Rhiiino/van-gogh/models/README.md

# Van Gogh — Models

STL files for the printed parts of one barrel. One file is one part.
