Rhiiino/van-gogh/media/README.md

# Van Gogh — Media

Photos and renders for the landing page. The printed-parts catalog is [catalog.md](../catalog.md).

## Images

| File | Use |
| --- | --- |
| `cover.png` | First image in [README.md](../README.md) |
| `hero-assembled.jpg` | Assembled barrel |
| `assembled-side.jpg` | Electronics side |
| `assembled-end.jpg` | Indexer end |
| `assembled-front.jpg` | Muzzle three-quarter |
| `assembled-top.jpg` | Top three-quarter |

## GIFs

| File | Use |
| --- | --- |
| `explode-assembled-to-open.gif` | Barrel explode, assembled to exploded and back |
| `explode-loop-centered-label.gif` | Centered explode with label |
| `explode-loop-centered-label-round.gif` | Same loop, Rival round left of the label |
| `explode-loop-end.gif` | Same loop from the indexer end |
| `explode-dial-label.gif` | DIAL explode with label |
| `explode-dial-framed-label.gif` | DIAL explode, open pose framed |
| `dial-cycle.gif` | DIAL cycle — feed, cam plunger, flywheel shots |
| `lasenoid-cycle-viewport-laser.gif` | Solid viewport, Material Preview laser |
