Rhiiino/van-gogh/catalog.md

# Van Gogh — Parts catalog

Visual index of printed parts for one barrel. One section per part. Quantities and specs: [bom.md](bom.md).

---

## actuation rod

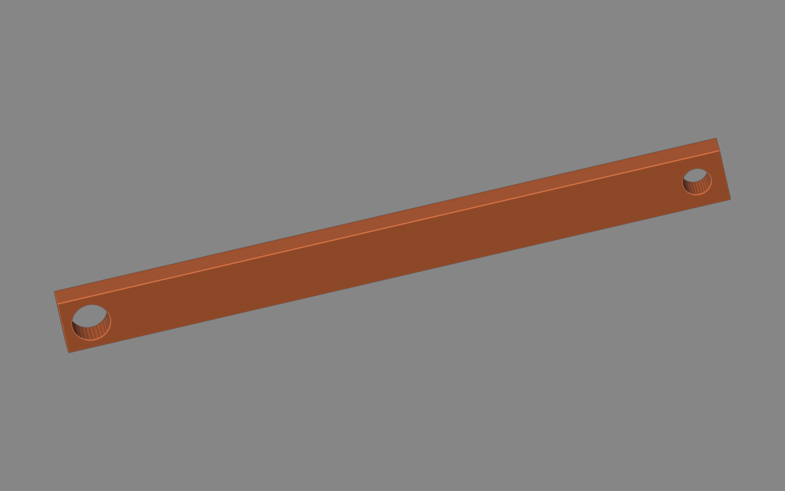
[picture p8: catalog/actuation-rod.png]
actuation rod


## ammo guide

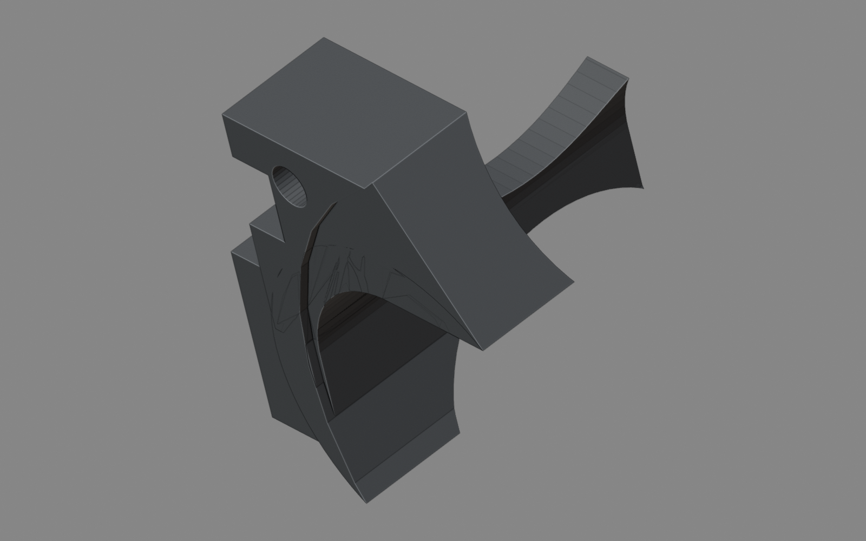
[picture p9: catalog/ammo-guide.png]
ammo guide


## barrel base L panel

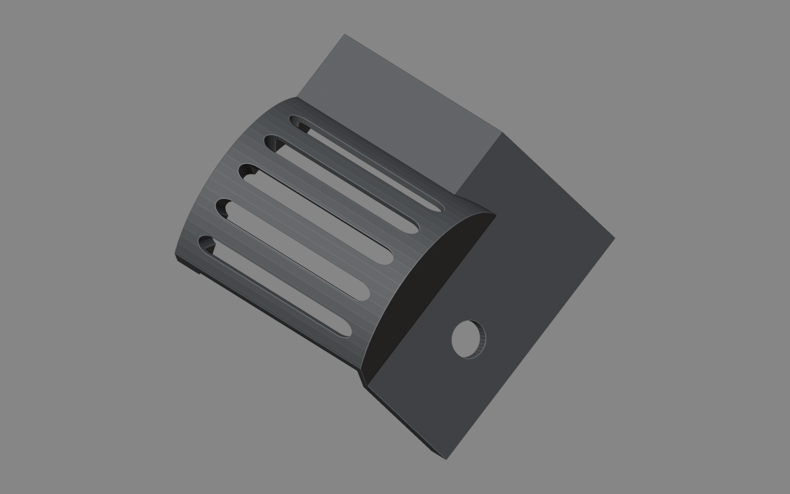
[picture p10: catalog/barrel-base-l-panel.png]
barrel base L panel


## barrel base R panel

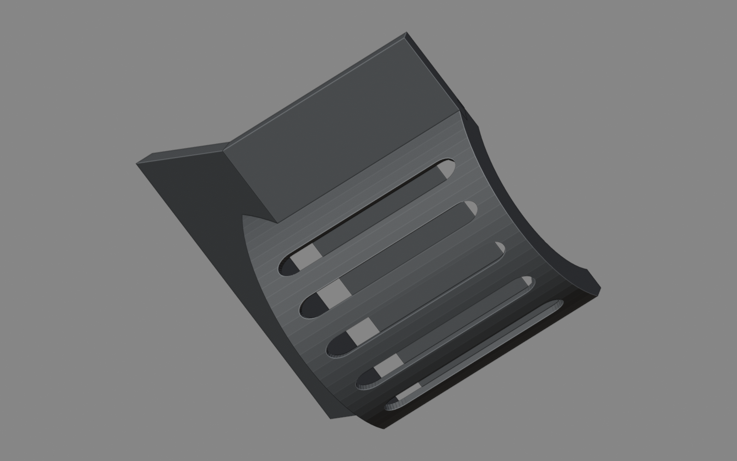
[picture p11: catalog/barrel-base-r-panel.png]
barrel base R panel


## barrel middle

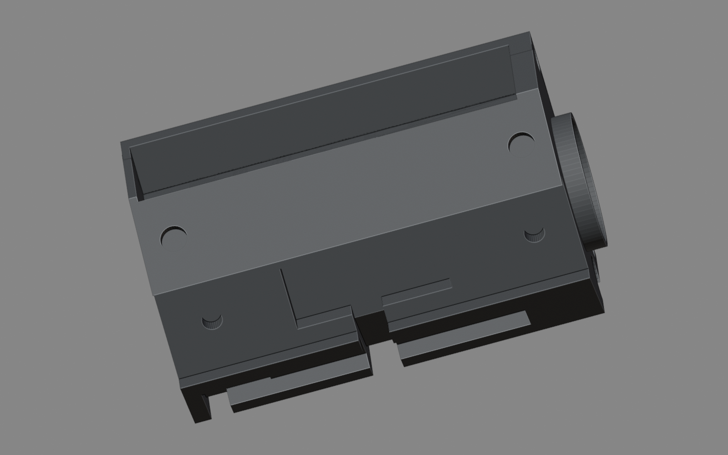
[picture p12: catalog/barrel-middle.png]
barrel middle


## BCU cover

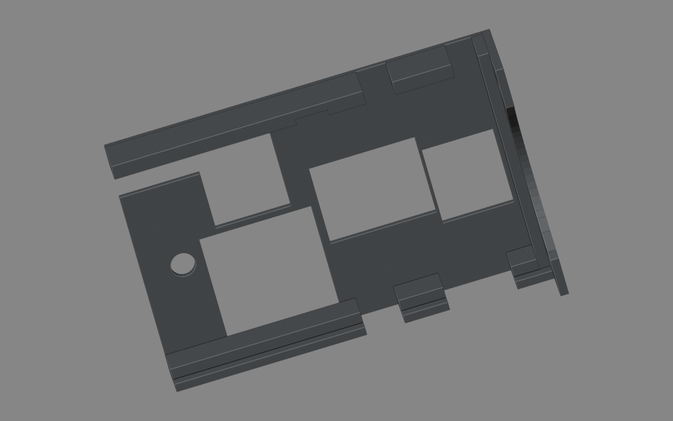
[picture p13: catalog/bcu-cover.png]
BCU cover


## cone

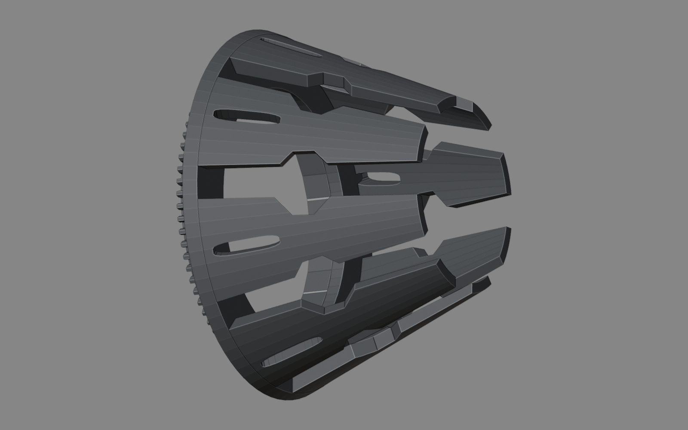
[picture p14: catalog/cone.png]
cone


## drum cam

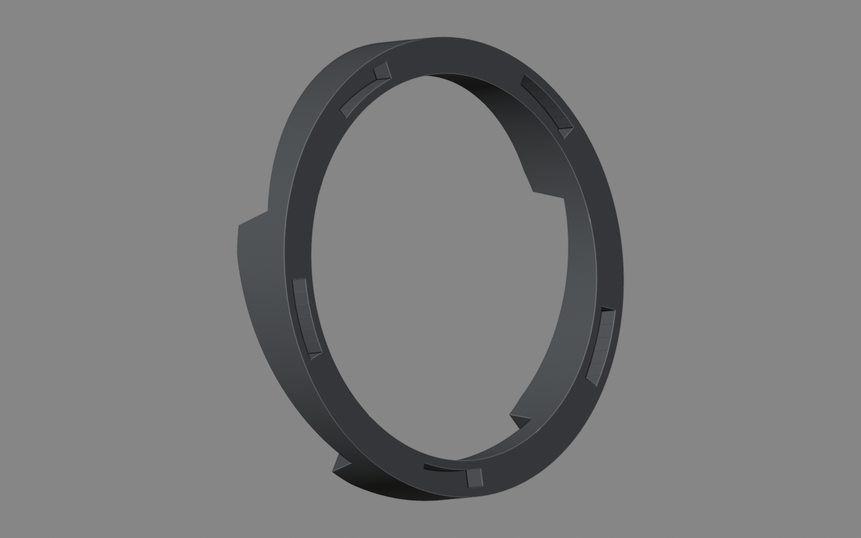
[picture p15: catalog/drum-cam.png]
drum cam


## drum main

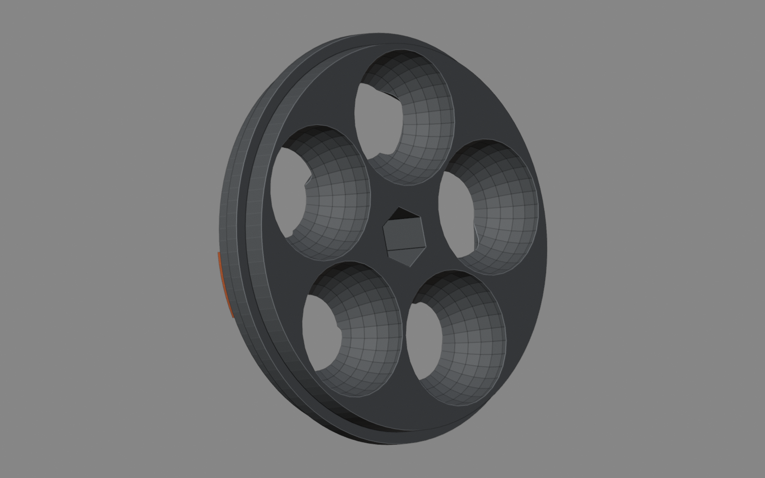
[picture p16: catalog/drum-main.png]
drum main


## drum motor shaft

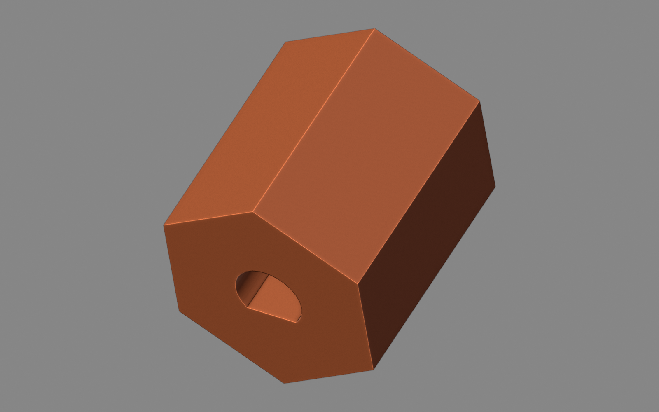
[picture p17: catalog/drum-motor-shaft.png]
drum motor shaft


## ESC casing

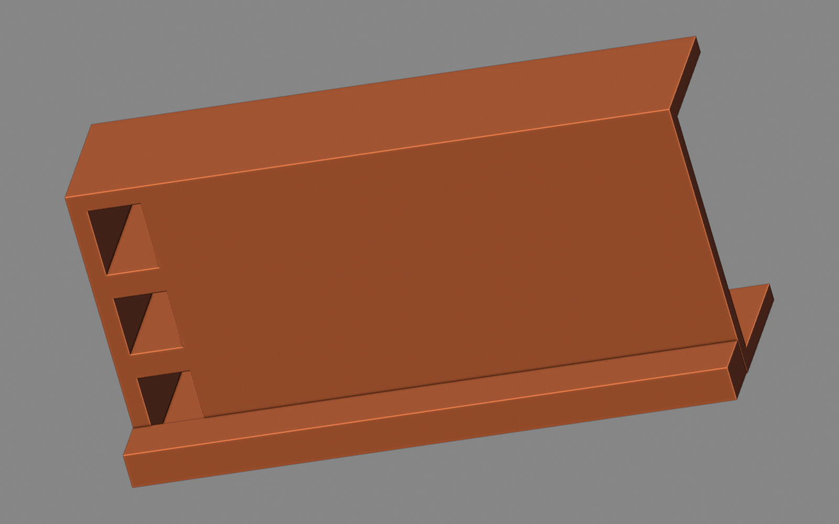
[picture p18: catalog/esc-casing.png]
ESC casing


## flywheel

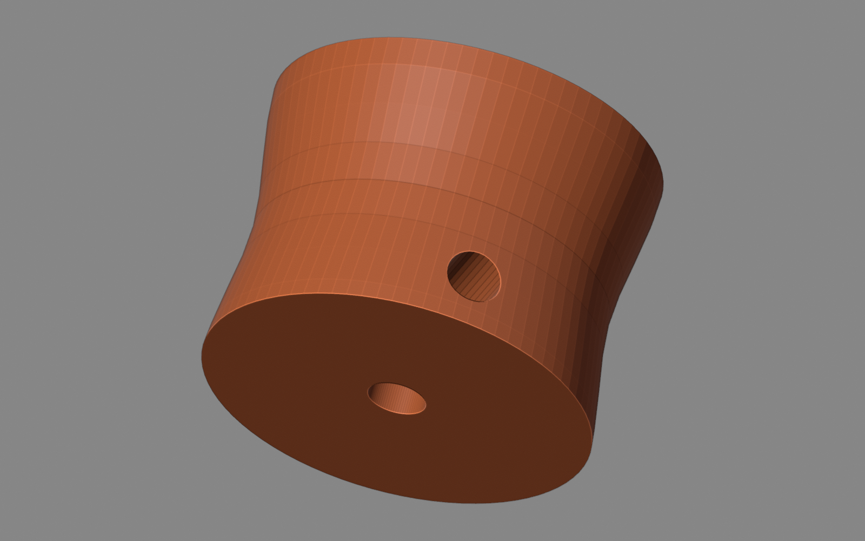
[picture p19: catalog/flywheel.png]
flywheel


## flywheel base

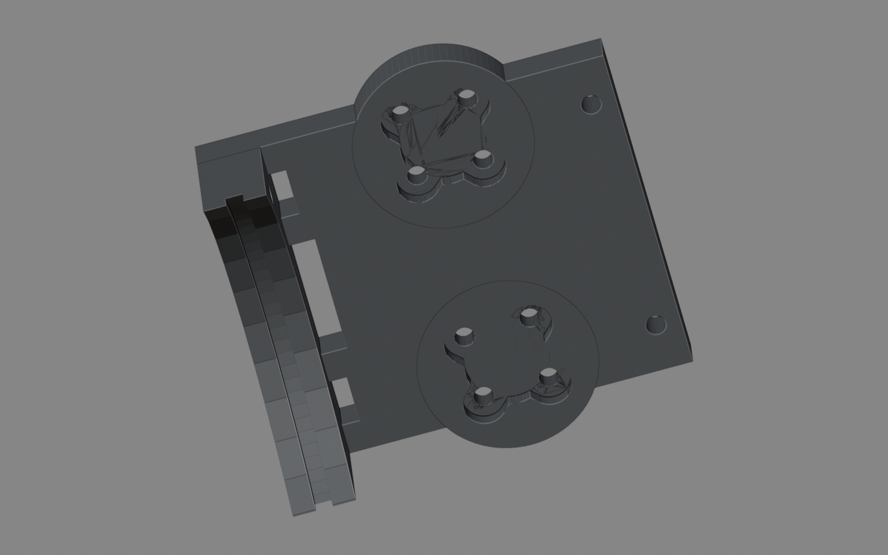
[picture p20: catalog/flywheel-base.png]
flywheel base


## flywheel carriage

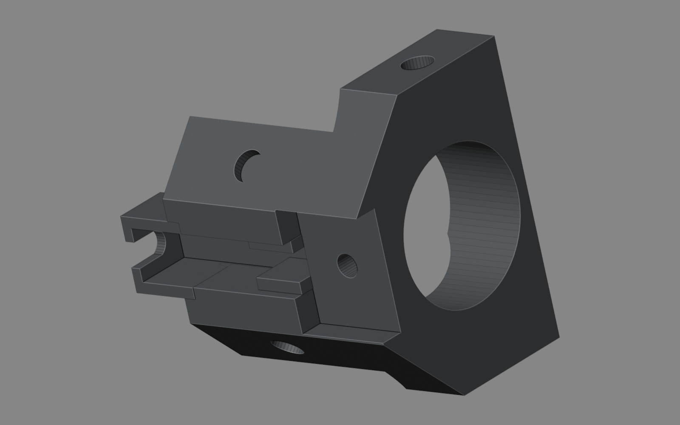
[picture p21: catalog/flywheel-carriage.png]
flywheel carriage


## lasenoid base

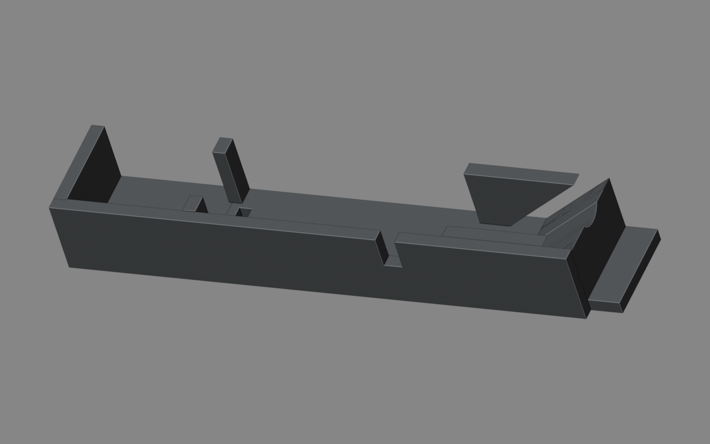
[picture p22: catalog/lasenoid-base.png]
lasenoid base


## laser carriage

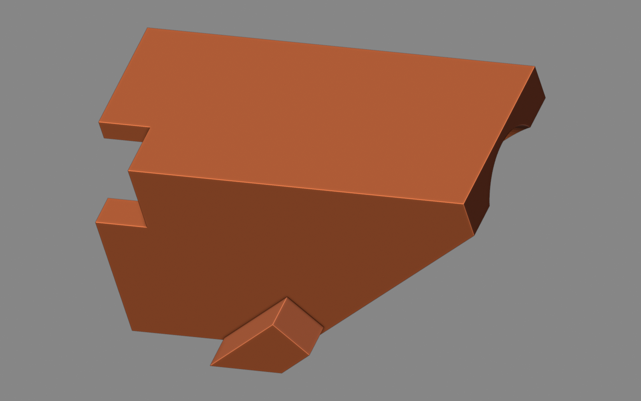
[picture p23: catalog/laser-carriage.png]
laser carriage


## led & cone n20 motor panel

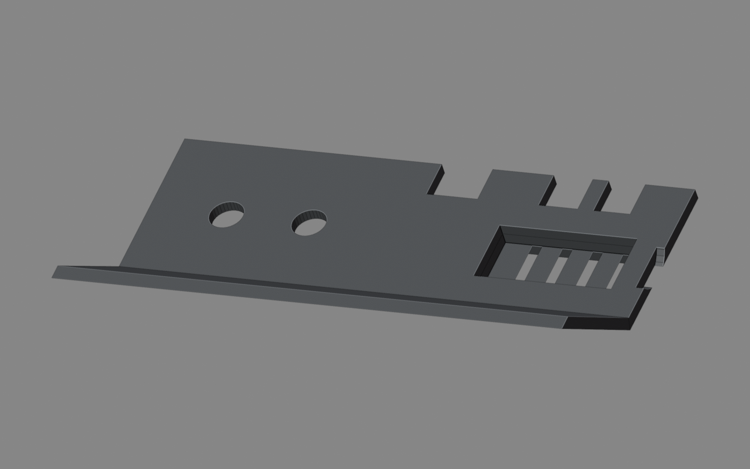
[picture p24: catalog/led-cone-n20-motor-panel.png]
led & cone n20 motor panel


## magazine lid

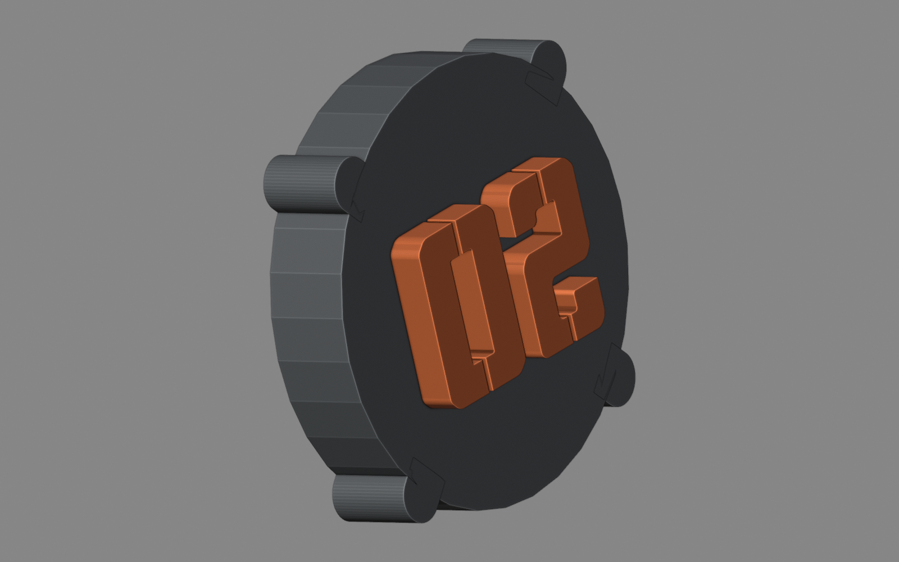
[picture p25: catalog/magazine-lid.png]
magazine lid


## magazine main

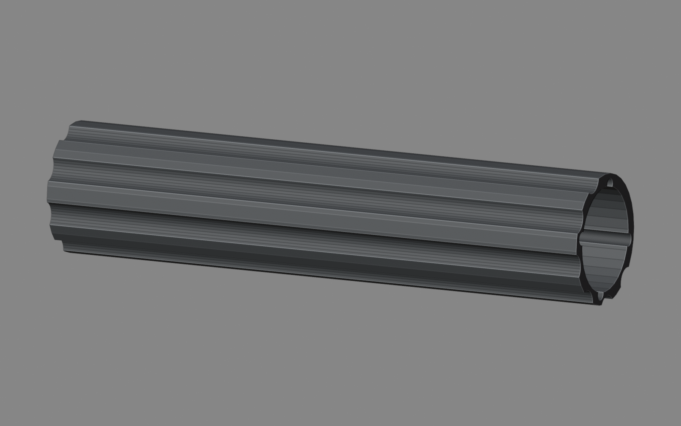
[picture p26: catalog/magazine-main.png]
magazine main


## magazine mount

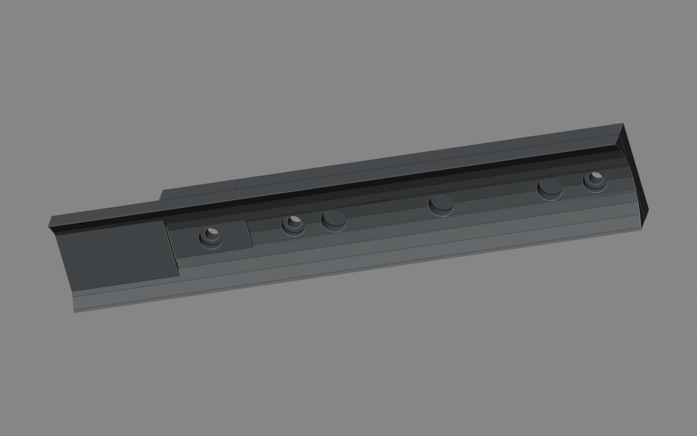
[picture p27: catalog/magazine-mount.png]
magazine mount


## magazine pusher

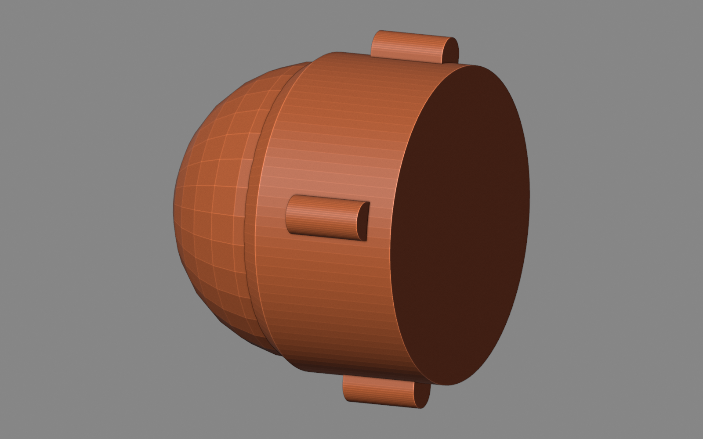
[picture p28: catalog/magazine-pusher.png]
magazine pusher


## module - name plate

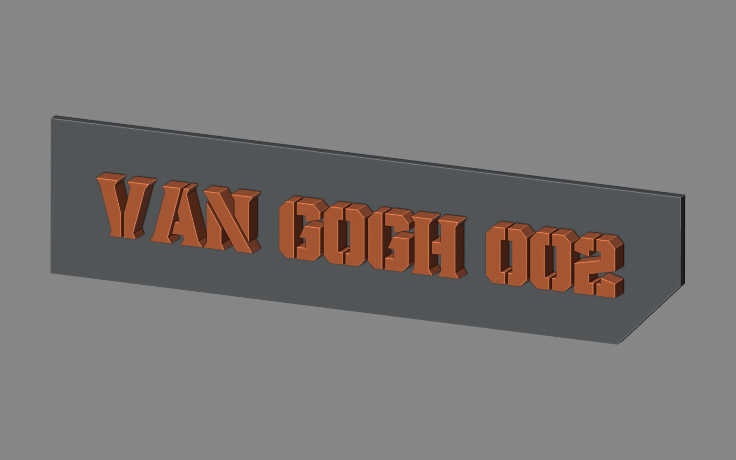
[picture p29: catalog/module-name-plate.png]
module - name plate


## name & lasenoid panel

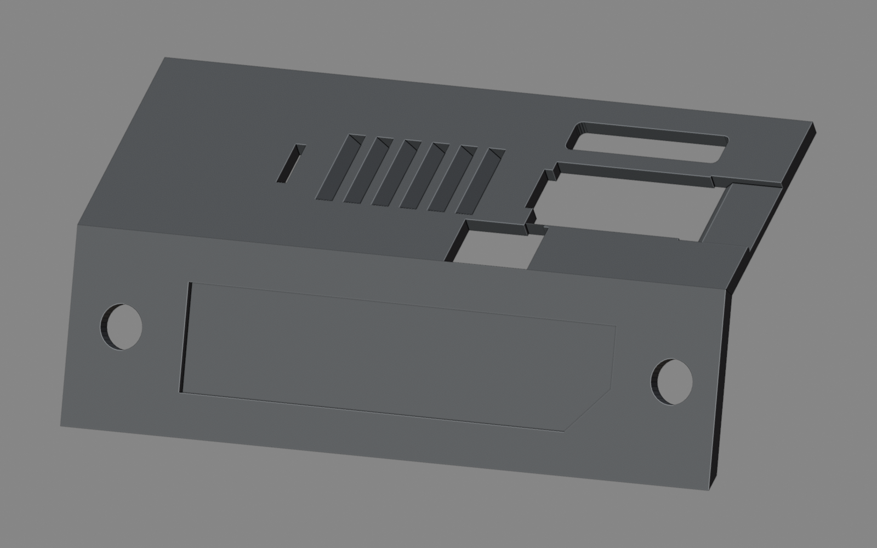
[picture p30: catalog/name-lasenoid-panel.png]
name & lasenoid panel


## PH ceiling / PYE connector

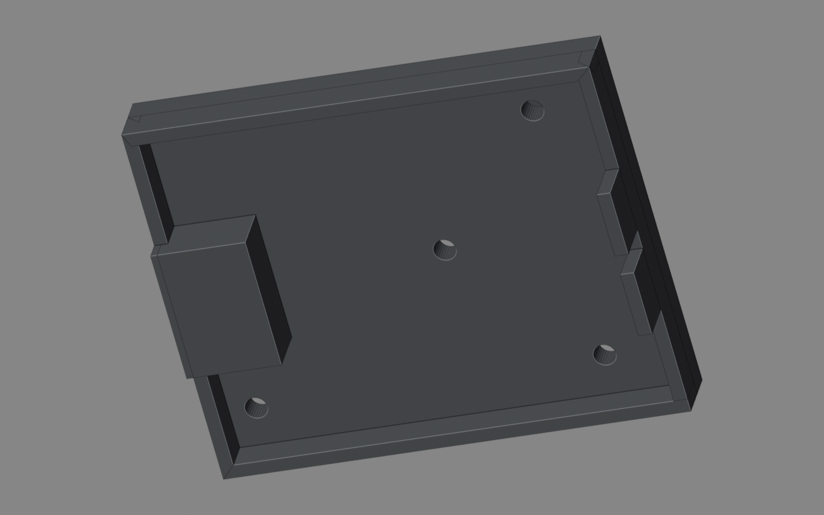
[picture p31: catalog/ph-ceiling-pye-connector.png]
PH ceiling / PYE connector


## pinion gear

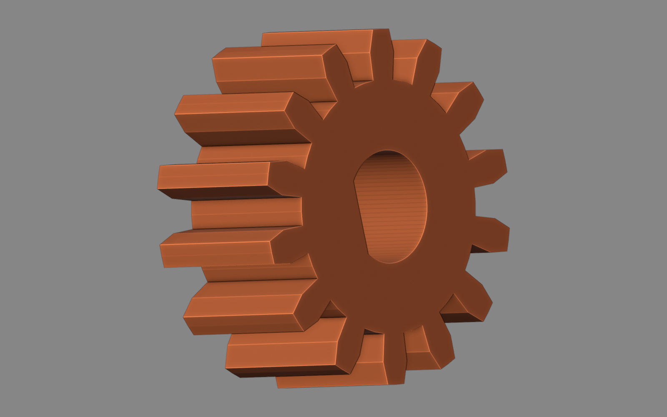
[picture p32: catalog/pinion-gear.png]
pinion gear


## plunger

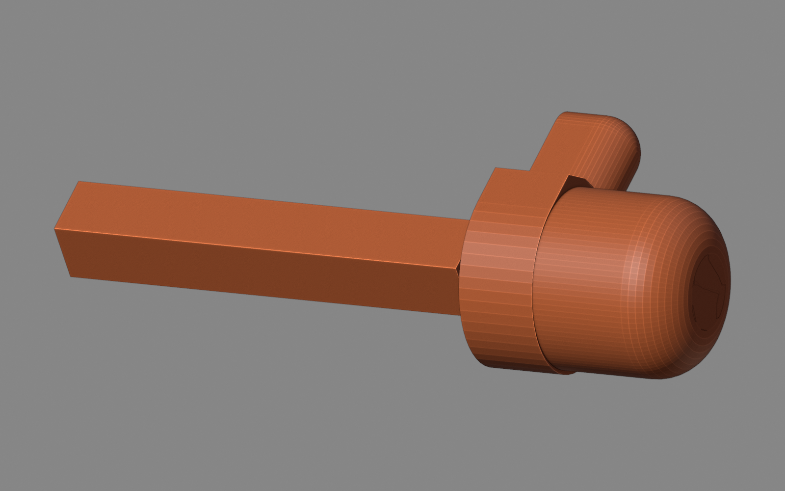
[picture p33: catalog/plunger.png]
plunger


## plunger mount

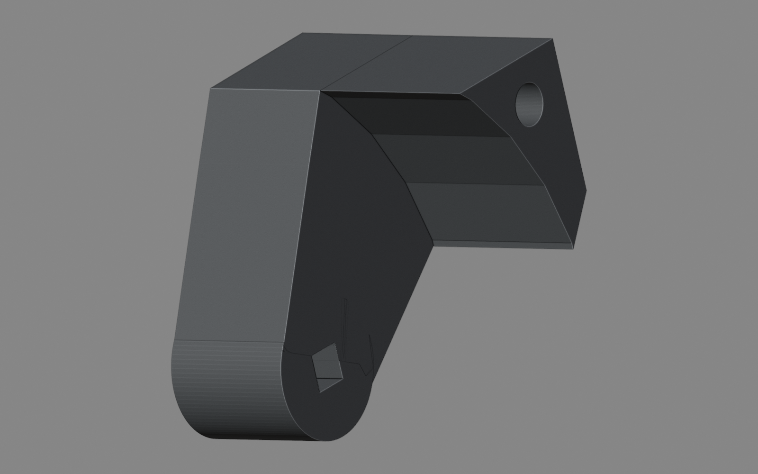
[picture p34: catalog/plunger-mount.png]
plunger mount


## power housing

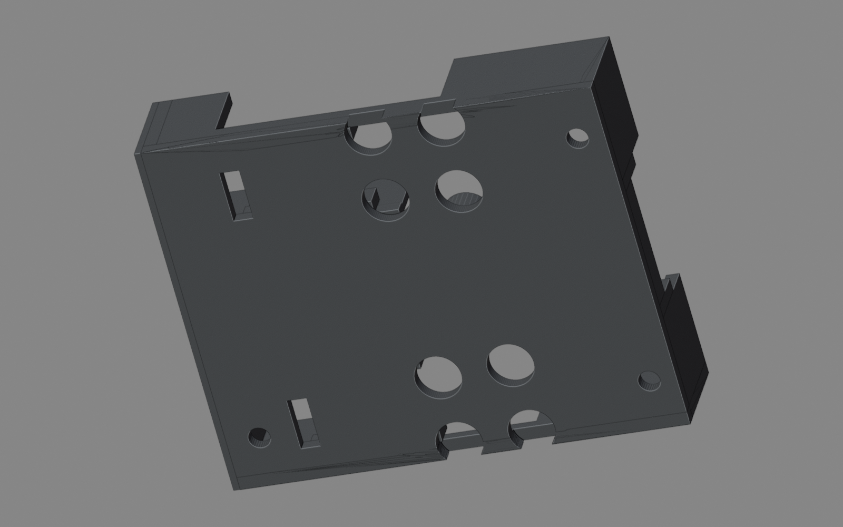
[picture p35: catalog/power-housing.png]
power housing


## solenoid / rod pin

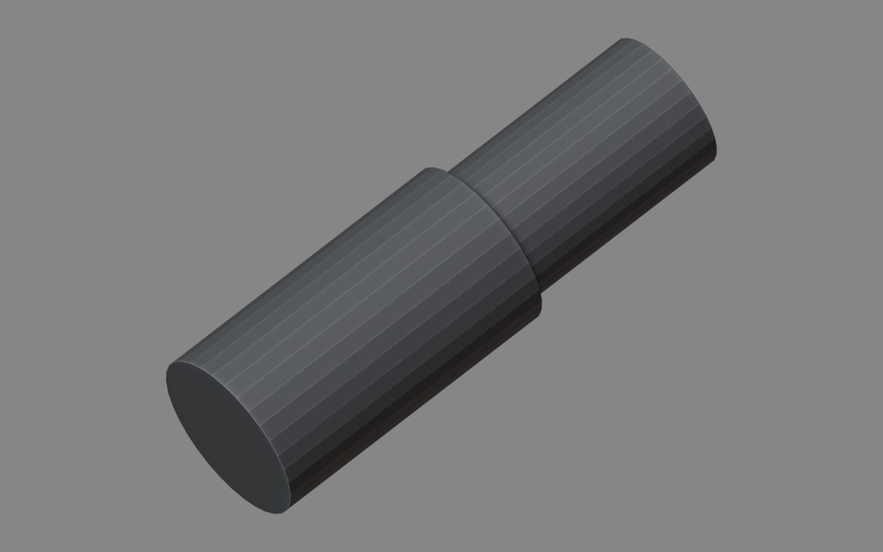
[picture p36: catalog/solenoid-rod-pin.png]
solenoid / rod pin
