Rhiiino/van-gogh/media/gifs/explode-dial-framed-label.gif

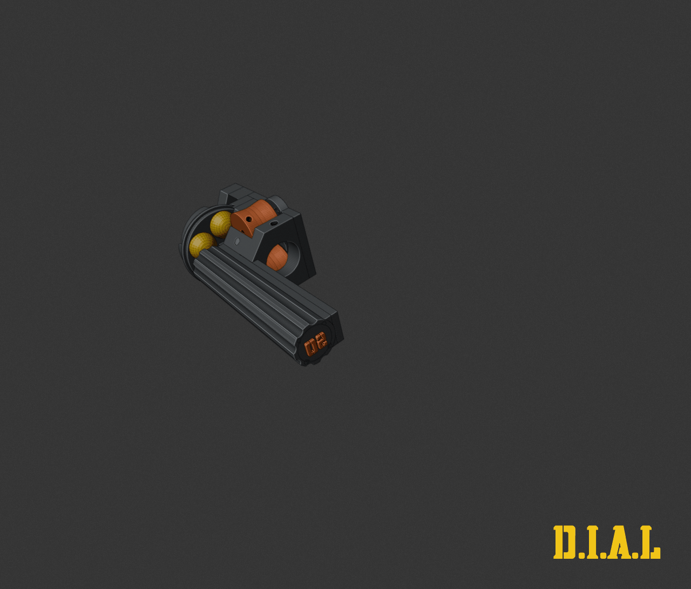
media/gifs/explode-dial-framed-label.gif
