Rhiiino/van-gogh/media/gifs/explode-dial-label.gif

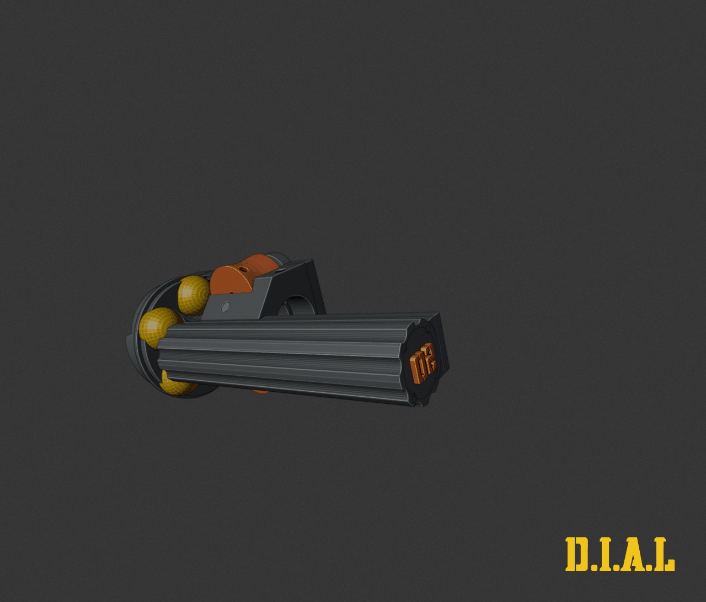
media/gifs/explode-dial-label.gif
