Rhiiino/van-gogh/media/gifs/explode-loop-end.gif

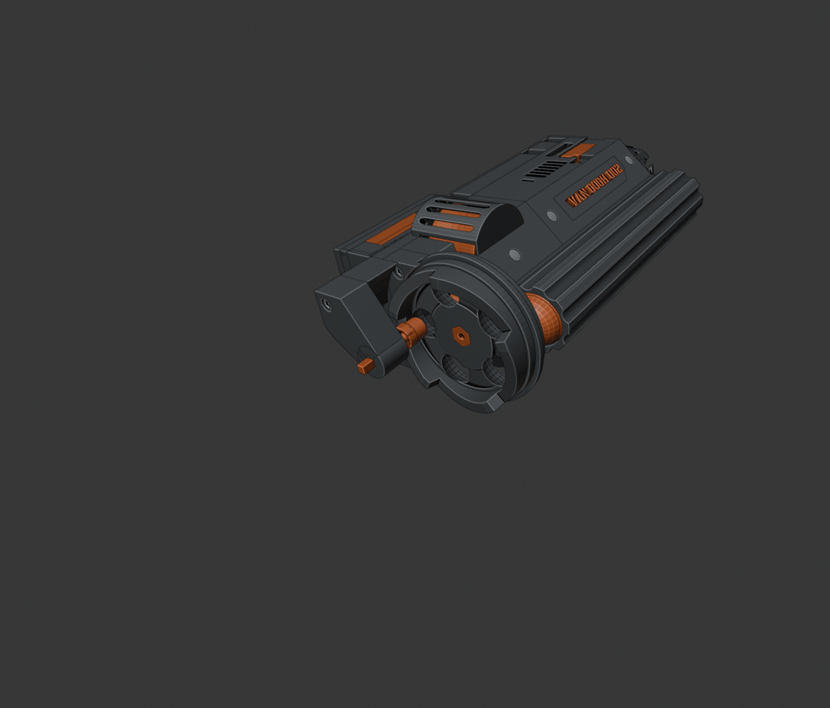
media/gifs/explode-loop-end.gif
