Rhiiino/van-gogh/cost.md

# Van Gogh — cost

Bought parts for **one** barrel. Printed parts are excluded. Quantities: [bom.md](bom.md).

**Total: $140.84**

Each line is this barrel’s share of the listing: pack price × quantity on the barrel ÷ pieces in the pack. Rows marked **est.** use a pack listing from 2026-10-10. Tax and shipping are omitted. The logic-board line is the amount paid for order Y14-2705430A, split across the five boards.

| Group | This barrel |
| --- | ---: |
| Mechanical | $79.02 |
| Fasteners | $3.50 |
| Connectors | $3.87 |
| Logic board | $54.45 |
| **Total** | **$140.84** |

Flywheel motors, the two ESCs, and the Pololu 6 V buck are $95.95 of the total.

## Mechanical

| Part | Qty | Listing | This barrel |
| --- | ---: | ---: | ---: |
| iFlight XING-E Pro 2207 1800KV | 2 | $70.99 / 4 | $35.50 |
| HNYYZL/LANRC 45A BLHeli_S ESC | 2 | $40.99 / 4 | $20.50 |
| uxcell 6706-2RS ring bearing | 1 | $7.31 | $7.31 |
| WS2812B LED stick | 1 | $5.95 est. | $5.95 |
| DWEII N20 | 2 | $9.99 / 4 est. | $5.00 |
| MEETOOT SM0537 solenoid, 6 V / 1.5 A | 1 | $7.99 / 2 est. | $4.00 |
| HiLetgo 5 V 650 nm laser | 1 | $6.79 / 10 est. | $0.68 |
| Plunger spring, 0.5 × 6 × 30 mm | 1 | $11.99 / 150 | $0.08 |

The motor 4-pack and the ESC 4-pack each cover two barrels. This table takes half of each.

## Fasteners

22 magnets, 12 M3 heat-set inserts, 20 M3 bolts. Eight of the bolts thread into the flywheel motors and have no insert.

| Part | Qty | Listing | This barrel |
| --- | ---: | ---: | ---: |
| 6 × 2 mm neodymium magnet | 22 | $8.99 / 100 est. | $1.98 |
| M3 heat-set insert | 12 | $9.99 / 130 est. | $0.92 |
| M3 bolt (6 / 8 / 12 / 35 mm) | 20 | ~$6 assortment est. | $0.60 |

## Connectors

| Part | Qty | Listing | This barrel |
| --- | ---: | ---: | ---: |
| Micro-Fit 3.0 1×6 pair | 1 | $21.99 / 60 housings | $0.73 |
| JST-PH 2.0 pigtails, 24 AWG | 5 | $16.99 / 120 wires | $1.56 |
| JST-PH 2.0 right-angle headers | 5 | $10.99 / 95 | $0.58 |
| XT90 male | 1 | $9.99 / 5 pair est. | $1.00 |

The Micro-Fit kit is 60 housings (30 male, 30 female), including two 1×6 of each gender. This barrel uses one pair, counted as 2 housings. The PH header kit is 95 right-angle headers; this barrel uses five (four 2-pin, one 3-pin). The pigtail kit includes 120 pre-crimped wires; this barrel uses 11 of them, two per 2-pin lead and three for the LED stick.

## Logic board

Refs: [board.md](board.md).

| Part | Qty | Listing | This barrel |
| --- | ---: | ---: | ---: |
| Pololu D36V50F6, +6 V | 1 | $39.95 | $39.95 |
| Aideepen ESP32-S3 Mini | 1 | $18.99 / 4 est. | $4.75 |
| Logic PCB, JLCPCB Y14-2705430A | 1 | $11.78 / 5 | $2.36 |
| MP1584EN, +5 V | 1 | $9.65 / 6 est. | $1.61 |
| IRLR024N (laser + solenoid) | 2 | $6.99 / 10 est. | $1.40 |
| WWZMDiB DRV8833 | 1 | $7.99 / 6 | $1.33 |
| Machined round male header, 1×40 | 1 | $0.95 | $0.95 |
| 2.54 mm square female header strip | 1 | $8.63 / 10 est. | $0.86 |
| Machined round female header, 1×40 | 1 | $0.55 | $0.55 |
| 100 µF 50 V electrolytic | 1 | $5.99 / 15 | $0.40 |
| 1206 ceramics (4 × 100 nF, 2 × 10 µF) | 6 | $7.99 / 320 | $0.15 |
| 1206 resistors (4 × 100 Ω, 2 × 10 kΩ, 1 × 330 Ω) | 7 | $9.99 / 1200 | $0.06 |
| 100 µF 16 V electrolytic | 2 | $16.99 / 630 | $0.05 |
| SS34 flyback diode | 1 | $8.99 / 300 est. | $0.03 |

The PCB order was five boards: merchandise $4.00, shipping $7.01, tax $0.77, paid $11.78. One board is $2.36. The ESP32 4-pack covers this barrel plus three other boards. One machined-header strip of each gender covers the ESP32-S3 Mini and the MP1584. One square-header strip covers the Pololu socket and the DRV8833 socket.
