Rhiiino/van-gogh/models/magazine main.stl

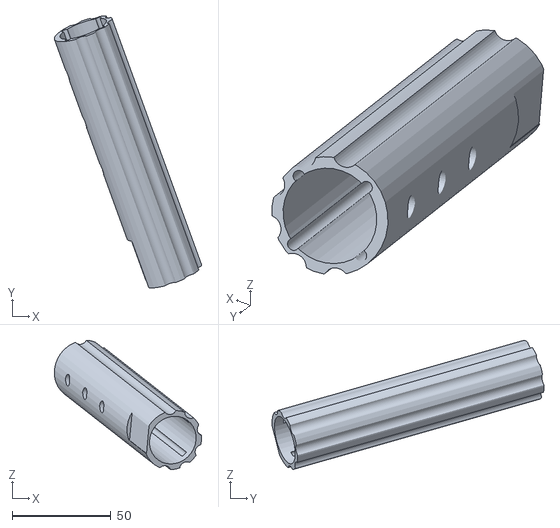
[picture p40: CAD file, 2026-10-12]
models/magazine main.stl
74.5 x 137.6 x 65.4
