Rhiiino/van-gogh/models/drum main.stl

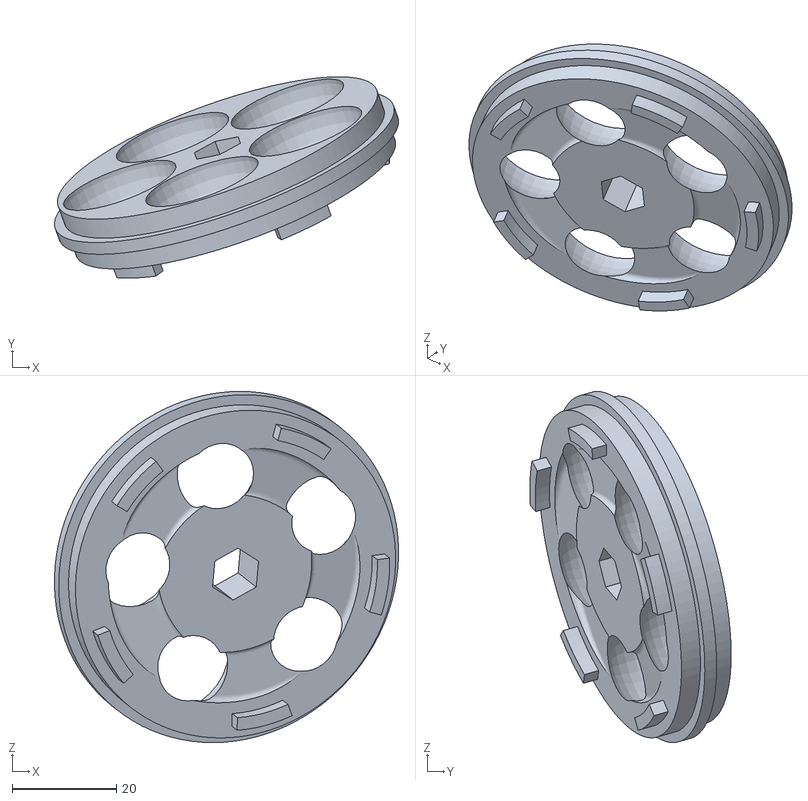
[picture p41: CAD file, 2026-10-12]
models/drum main.stl
65.9 x 38.6 x 67.3
