Rhiiino/van-gogh/models/plunger.stl

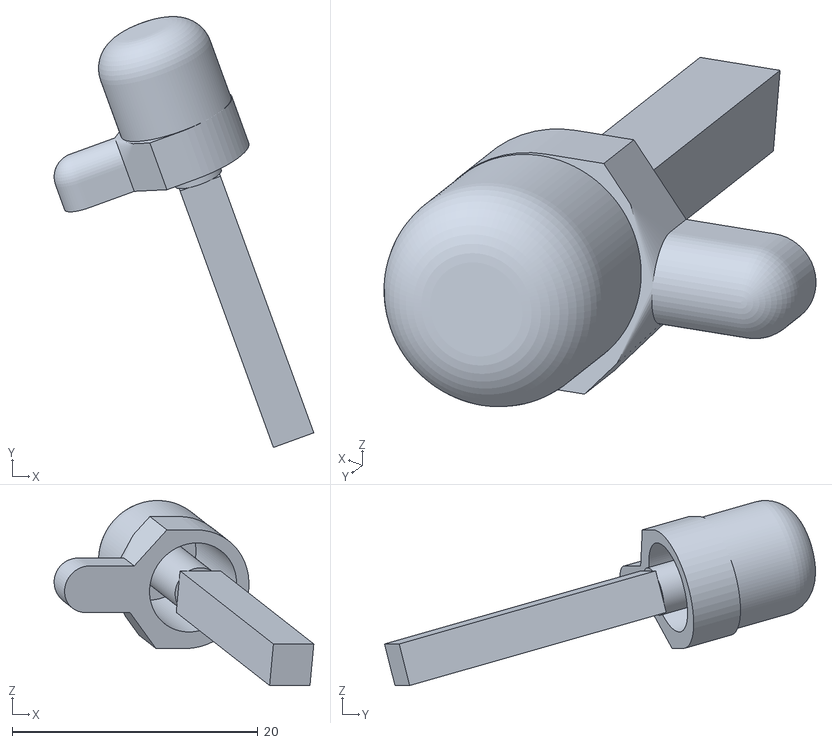
[picture p42: CAD file, 2026-10-12]
models/plunger.stl
21.1 x 35.1 x 15.1
