Rhiiino/van-gogh/models/flywheel.stl

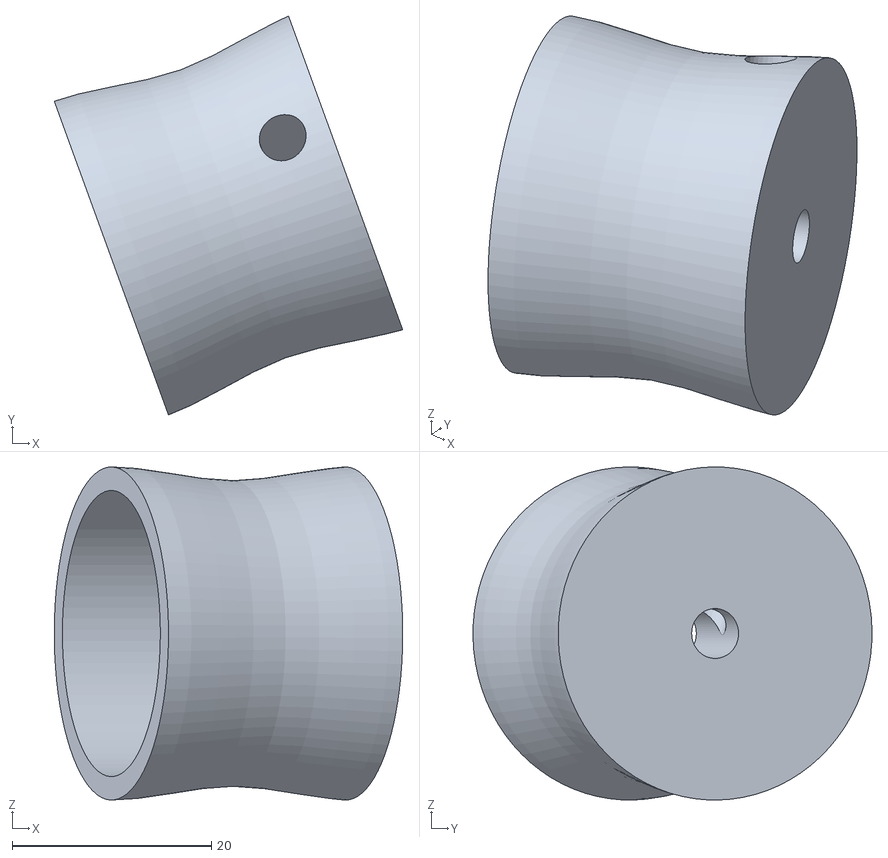
[picture p43: CAD file, 2026-10-12]
models/flywheel.stl
34.9 x 40.0 x 33.4
