Rhiiino/van-gogh/models/BCU cover.stl

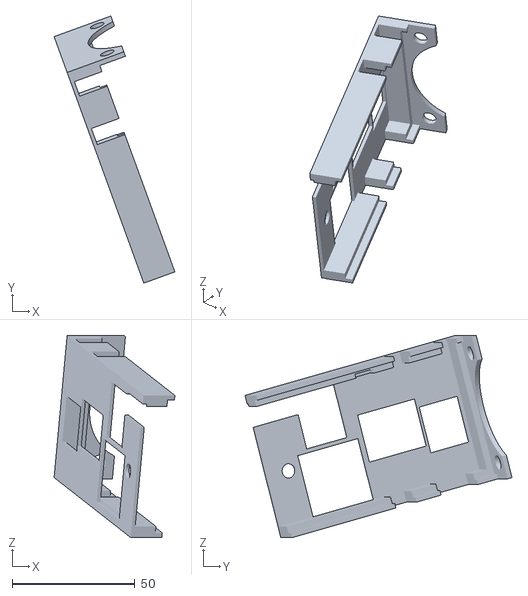
[picture p44: CAD file, 2026-10-12]
models/BCU cover.stl
49.3 x 108.9 x 82.5
