Rhiiino/van-gogh/models/ammo guide.stl

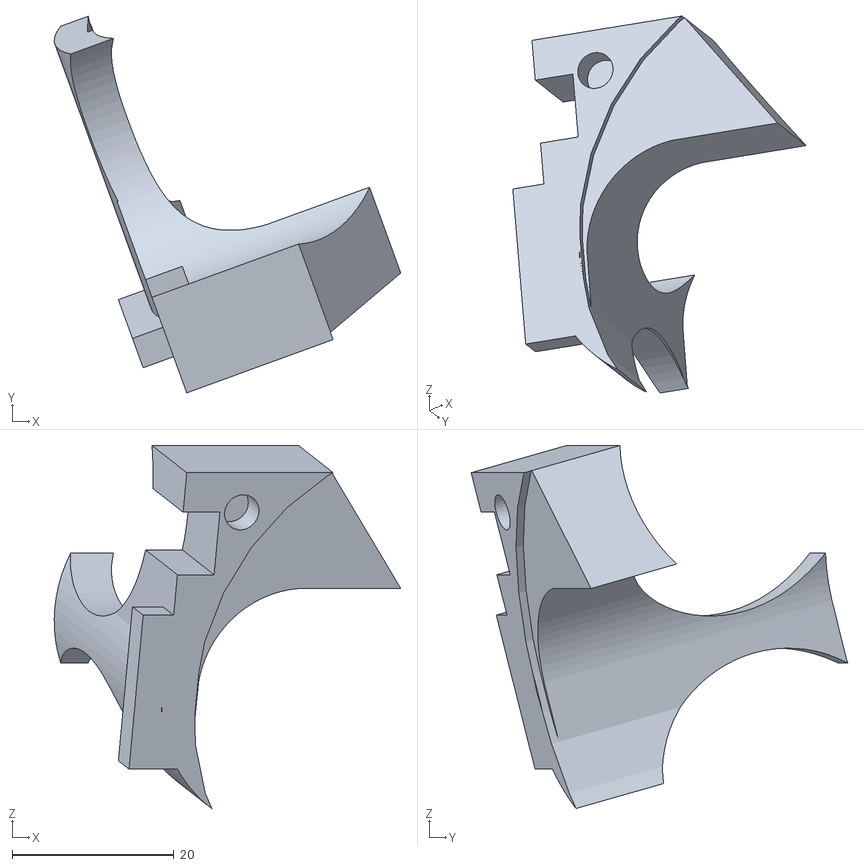
[picture p45: CAD file, 2026-10-12]
models/ammo guide.stl
42.8 x 46.5 x 44.9
