Rhiiino/van-gogh/models/magazine mount.stl

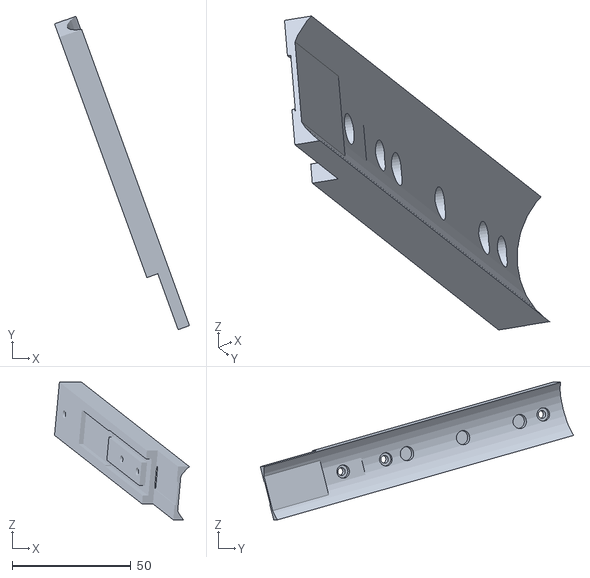
[picture p46: CAD file, 2026-10-12]
models/magazine mount.stl
56.8 x 131.8 x 57.9
