Rhiiino/van-gogh/models/flywheel carriage.stl

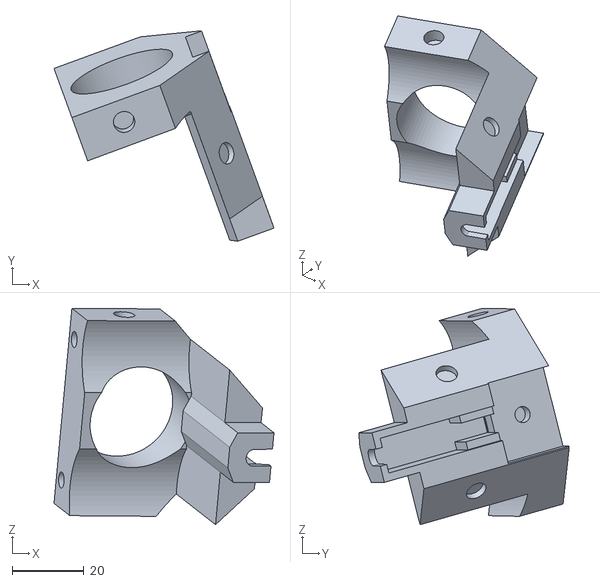
[picture p47: CAD file, 2026-10-12]
models/flywheel carriage.stl
61.2 x 58.6 x 60.2
