Rhiiino/van-gogh/models/pinion gear.stl

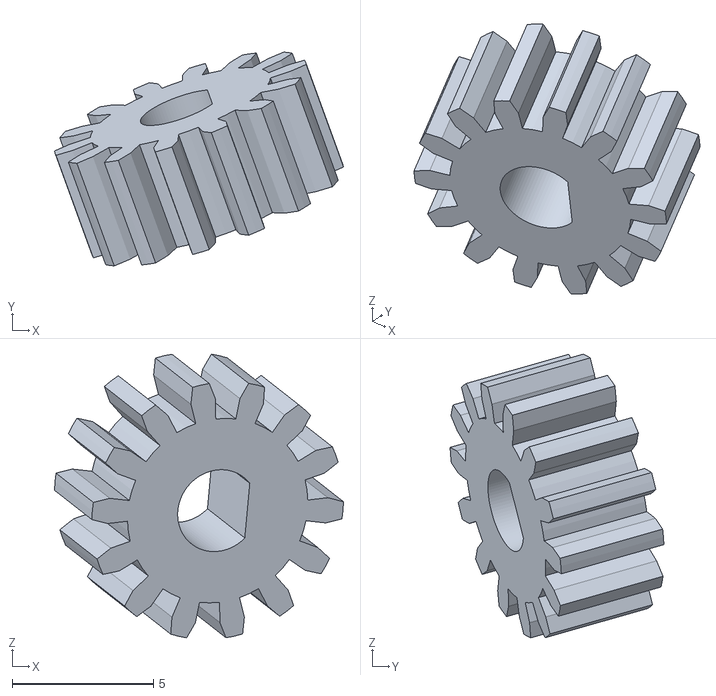
[picture p48: CAD file, 2026-10-12]
models/pinion gear.stl
10.2 x 7.57 x 10.0
