Rhiiino/van-gogh/models/cone.stl

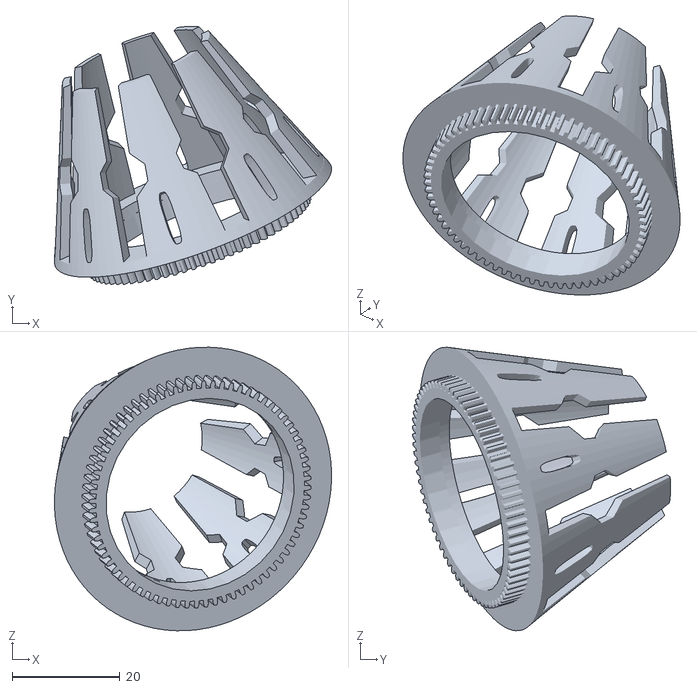
[picture p49: CAD file, 2026-10-12]
models/cone.stl
51.4 x 47.9 x 52.6
