Rhiiino/van-gogh/models/magazine lid.stl

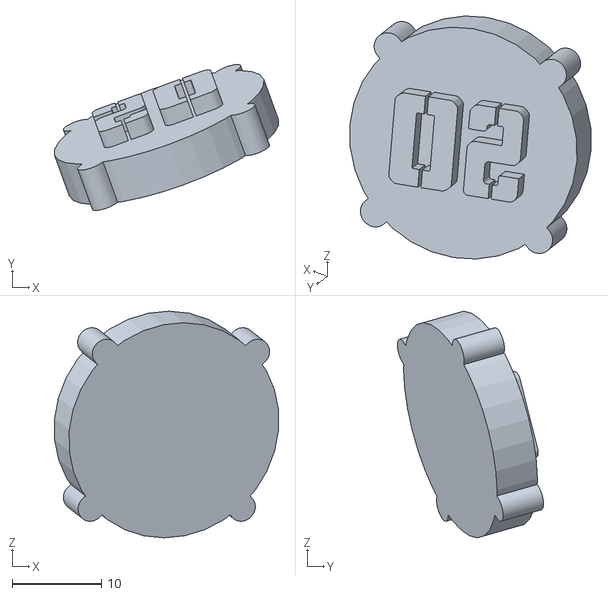
[picture p50: CAD file, 2026-10-12]
models/magazine lid.stl
25.1 x 16.4 x 25.4
