Rhiiino/van-gogh/models/name & lasenoid panel.stl

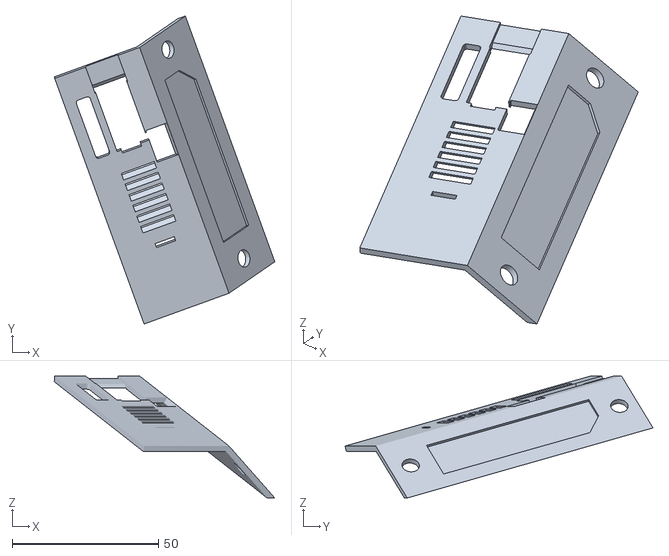
[picture p51: CAD file, 2026-10-12]
models/name & lasenoid panel.stl
75.5 x 105.4 x 41.7
