Rhiiino/van-gogh/models/flywheel base.stl

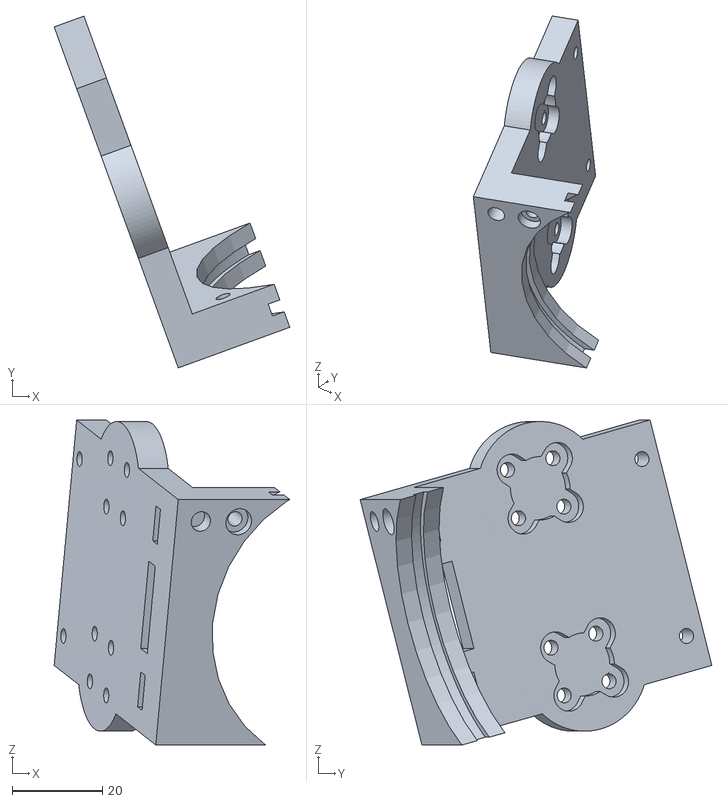
[picture p52: CAD file, 2026-10-12]
models/flywheel base.stl
52.1 x 77.8 x 71.8
