Rhiiino/van-gogh/models/barrel base L panel.stl

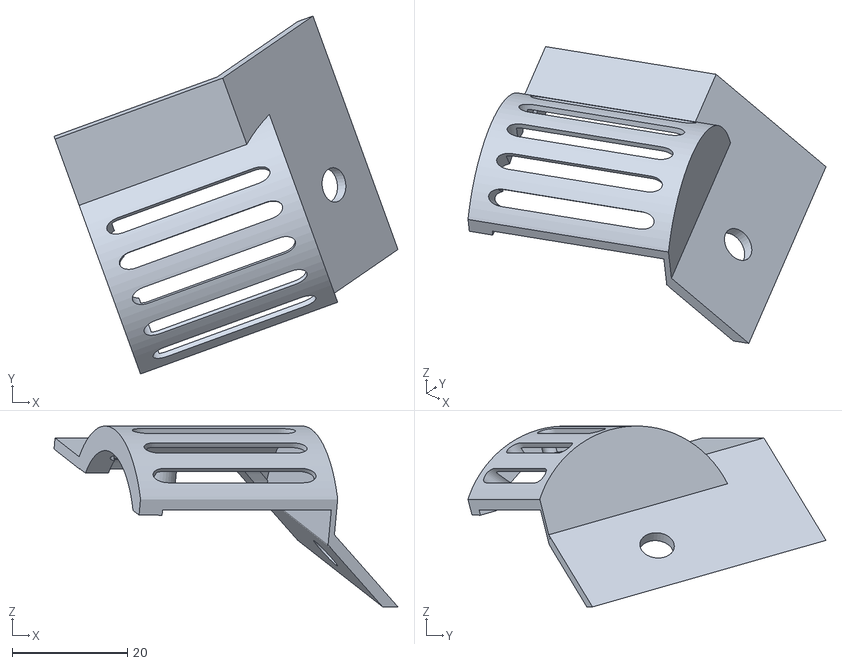
[picture p53: CAD file, 2026-10-12]
models/barrel base L panel.stl
59.6 x 62.1 x 31.4
