Rhiiino/van-gogh/models/barrel middle.stl

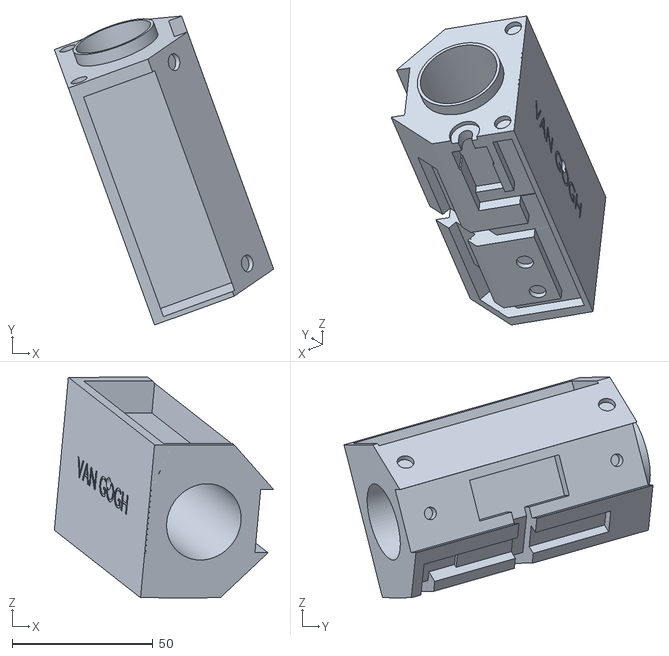
[picture p54: CAD file, 2026-10-12]
models/barrel middle.stl
77.8 x 109.6 x 78.3
