Rhiiino/van-gogh/models/drum cam.stl

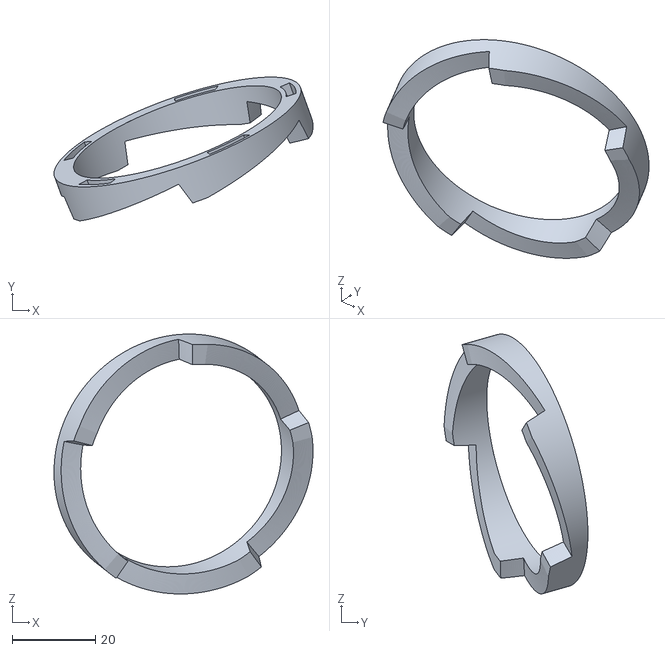
[picture p55: CAD file, 2026-10-12]
models/drum cam.stl
62.4 x 34.6 x 62.6
