Rhiiino/van-gogh/models/PH ceiling ∕ PYE connector.stl

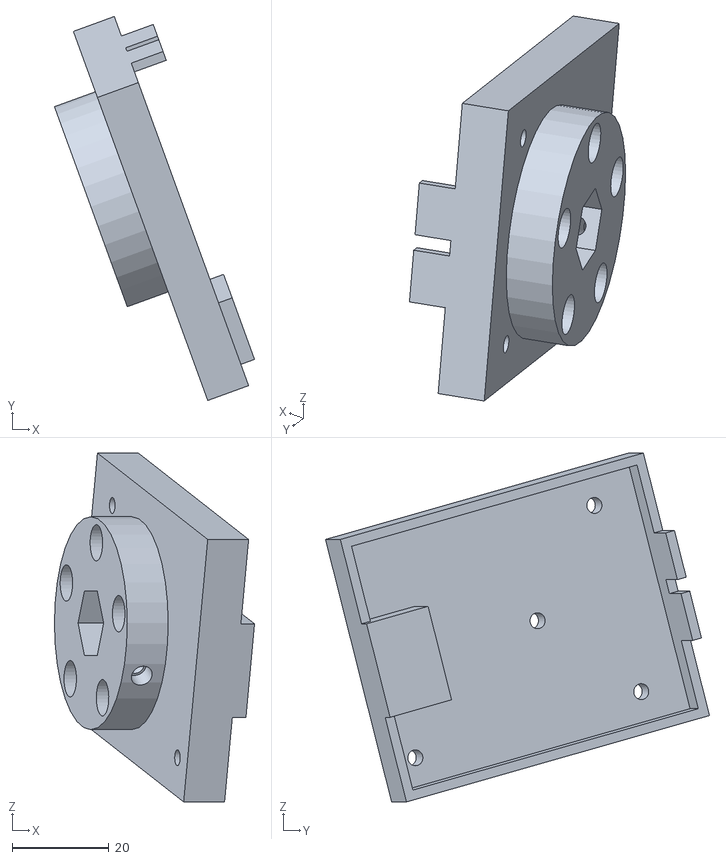
[picture p56: CAD file, 2026-10-12]
models/PH ceiling ∕ PYE connector.stl
41.4 x 79.4 x 72.1
