Rhiiino/van-gogh/models/magazine pusher.stl

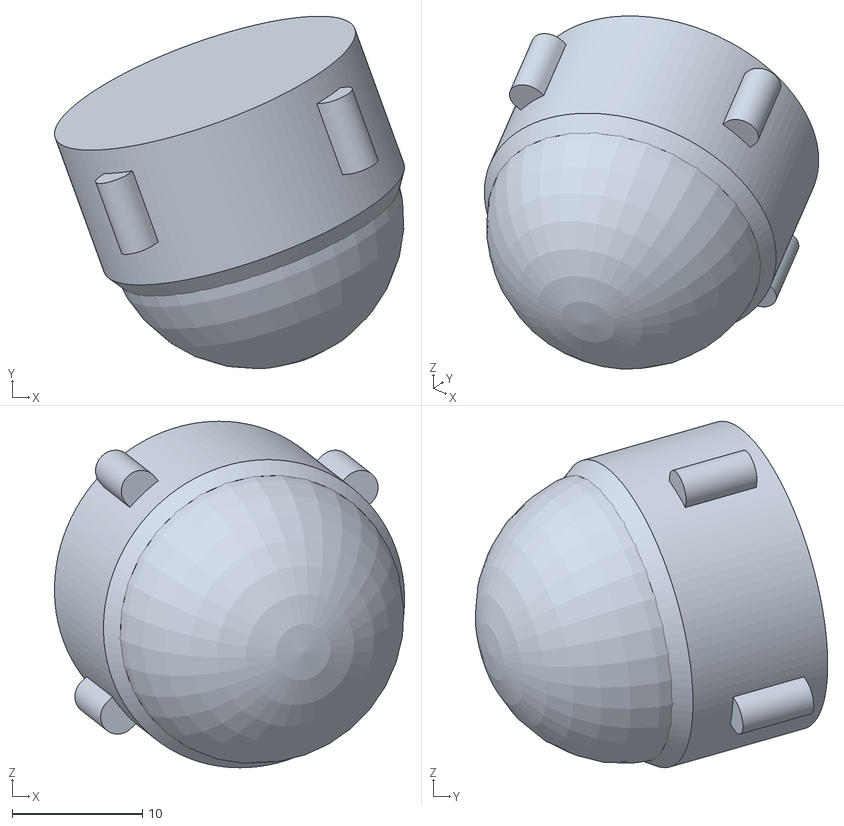
[picture p57: CAD file, 2026-10-12]
models/magazine pusher.stl
26.9 x 27.1 x 26.6
