Rhiiino/van-gogh/models/drum motor shaft.stl

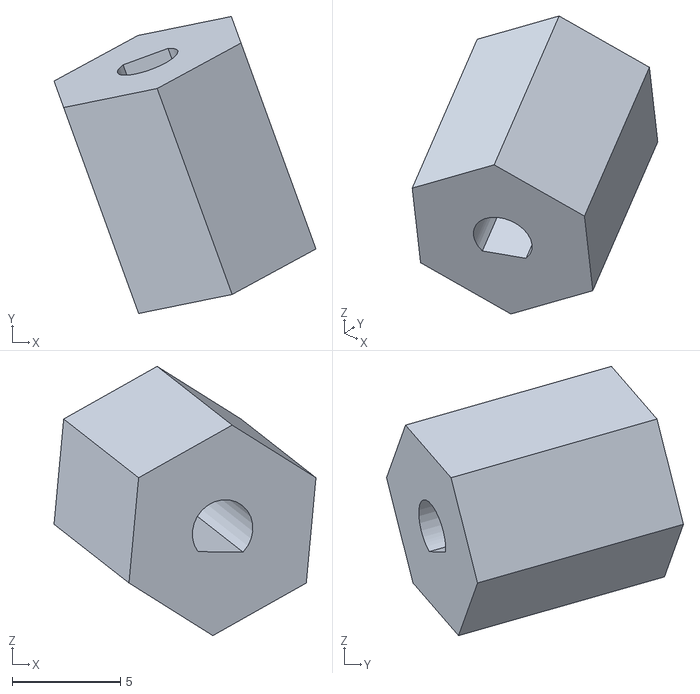
[picture p58: CAD file, 2026-10-12]
models/drum motor shaft.stl
12.1 x 13.7 x 12.5
