Rhiiino/van-gogh/models/actuation rod.stl

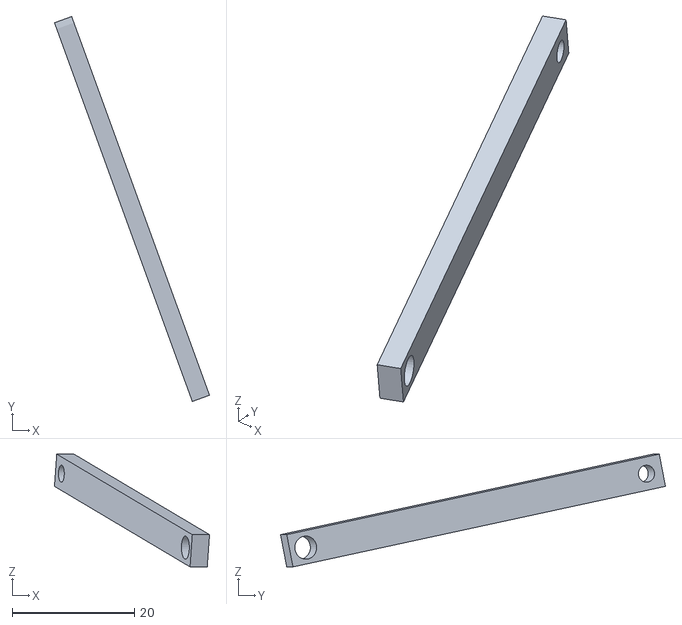
[picture p59: CAD file, 2026-10-12]
models/actuation rod.stl
25.4 x 63.0 x 18.4
