Rhiiino/van-gogh/models/module - name plate.stl

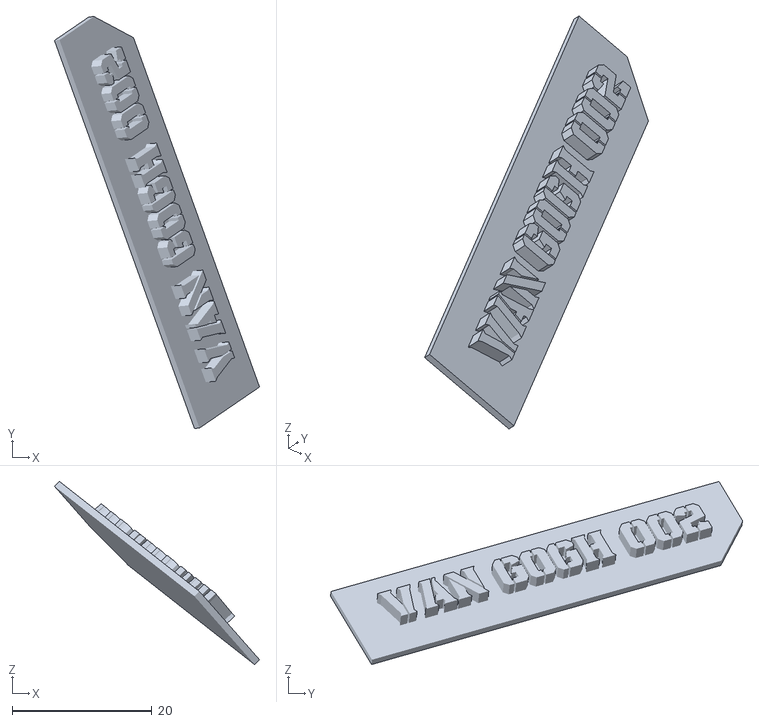
[picture p60: CAD file, 2026-10-12]
models/module - name plate.stl
29.4 x 59.0 x 26.2
