Rhiiino/van-gogh/models/solenoid ∕ rod pin.stl

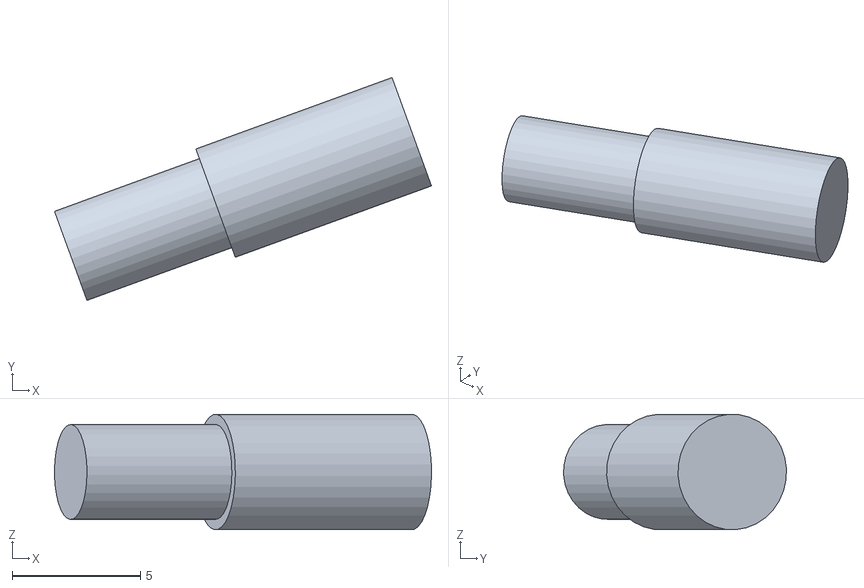
[picture p61: CAD file, 2026-10-12]
models/solenoid ∕ rod pin.stl
14.7 x 8.68 x 4.49
