Rhiiino/van-gogh/models/plunger mount.stl

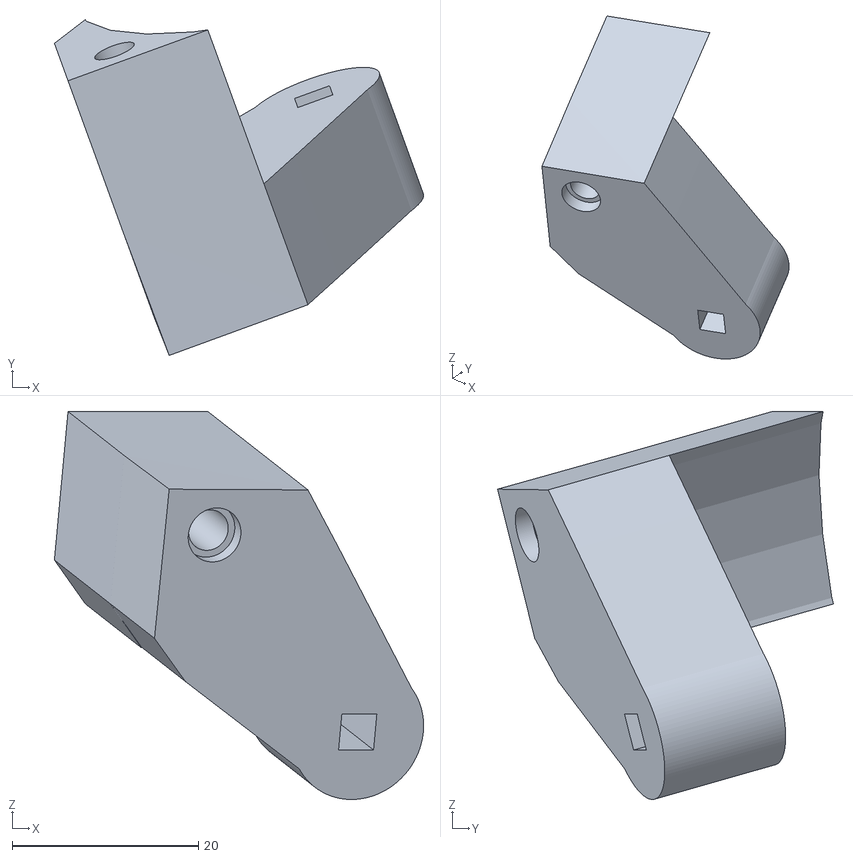
[picture p62: CAD file, 2026-10-12]
models/plunger mount.stl
39.6 x 36.1 x 41.7
