Rhiiino/van-gogh/models/laser carriage.stl

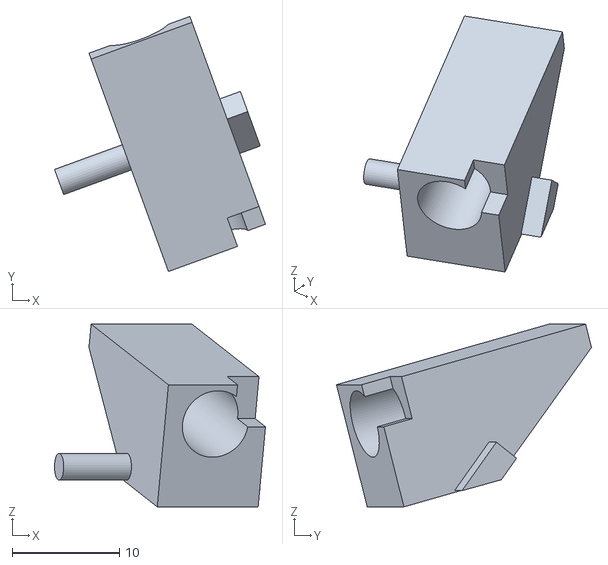
[picture p63: CAD file, 2026-10-12]
models/laser carriage.stl
19.6 x 23.8 x 17.0
