Rhiiino/van-gogh/models/ESC casing.stl

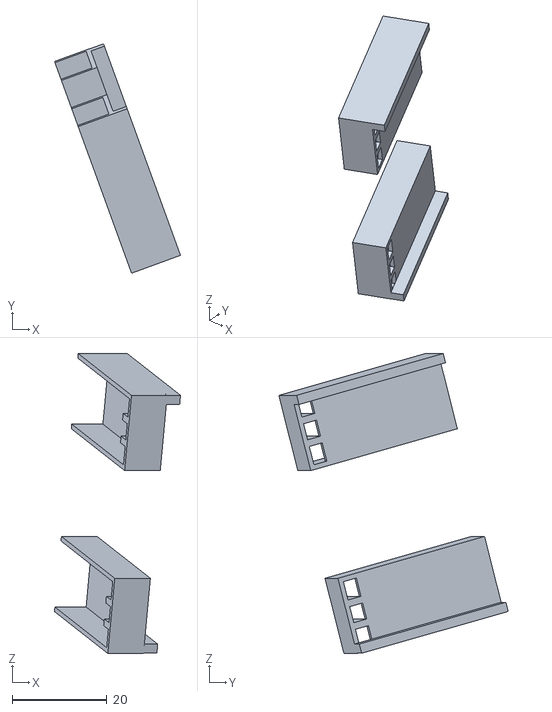
[picture p64: CAD file, 2026-10-12]
models/ESC casing.stl
26.5 x 48.3 x 63.2
