Rhiiino/van-gogh/models/power housing.stl

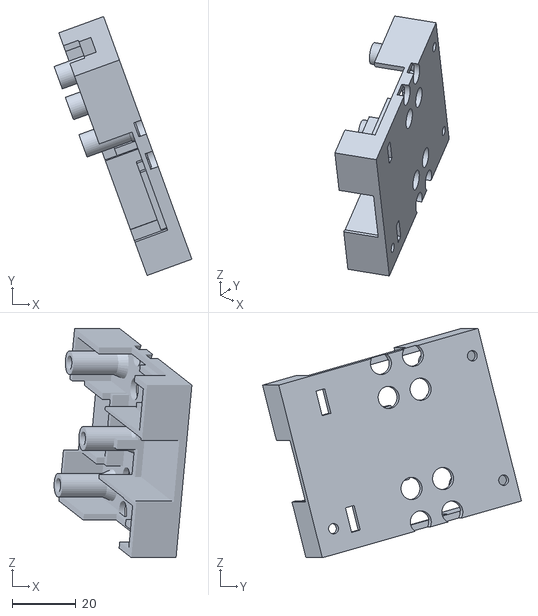
[picture p65: CAD file, 2026-10-12]
models/power housing.stl
43.3 x 81.4 x 72.1
