Rhiiino/van-gogh/models/lasenoid base.stl

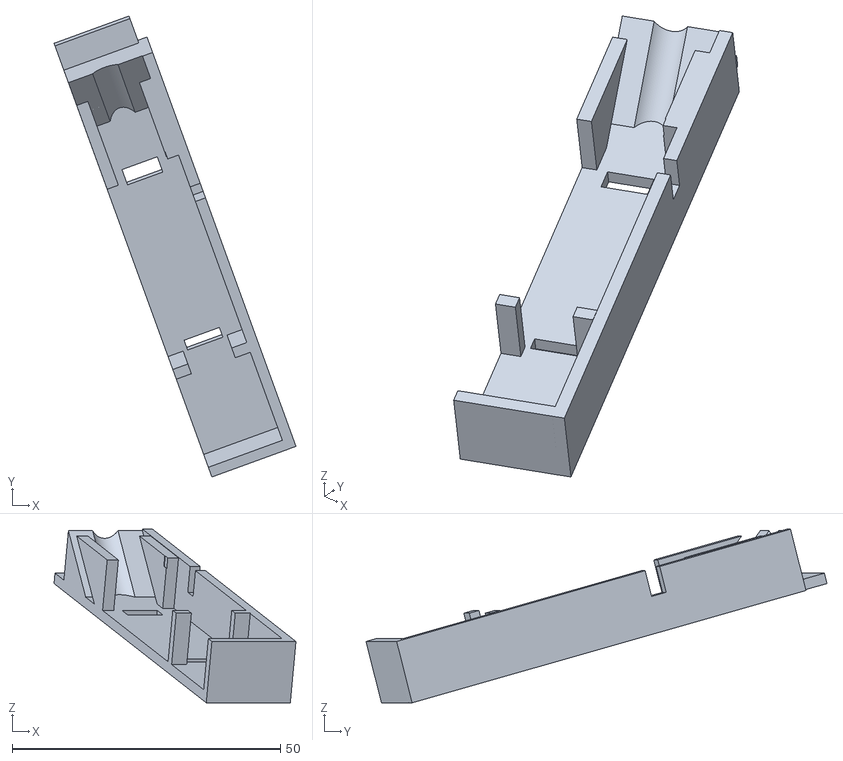
[picture p66: CAD file, 2026-10-12]
models/lasenoid base.stl
45.1 x 85.9 x 32.4
