Rhiiino/van-gogh/models/led & cone n20 motor panel.stl

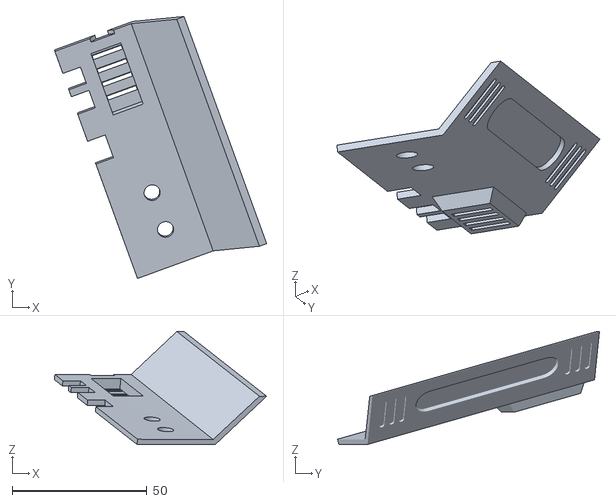
[picture p67: CAD file, 2026-10-12]
models/led & cone n20 motor panel.stl
78.7 x 97.1 x 41.9
