Rhiiino/van-gogh/models/barrel base R panel.stl

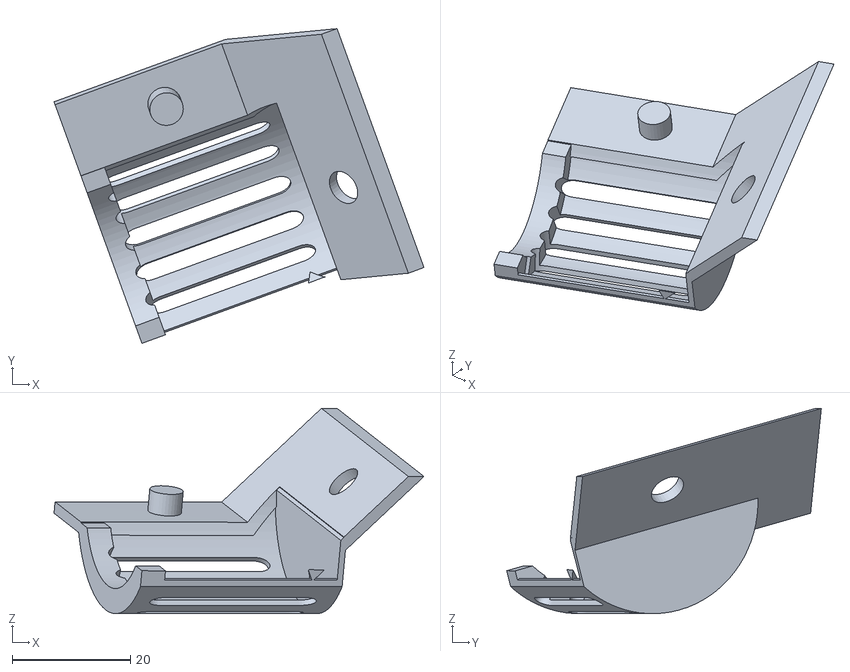
[picture p68: CAD file, 2026-10-12]
models/barrel base R panel.stl
62.7 x 53.3 x 34.8
