Rhiiino/van-gogh/media/gifs/explode-assembled-to-open.gif

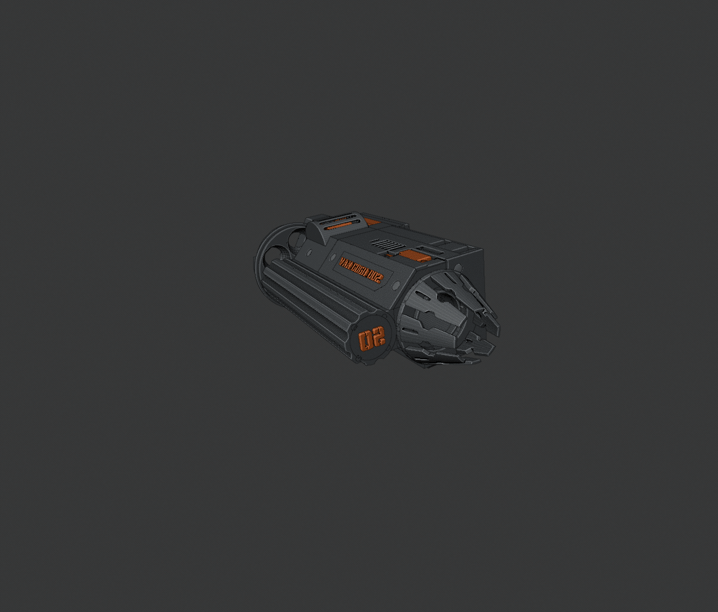
media/gifs/explode-assembled-to-open.gif
