Rhiiino/van-gogh/media/images/assembled-front.jpg

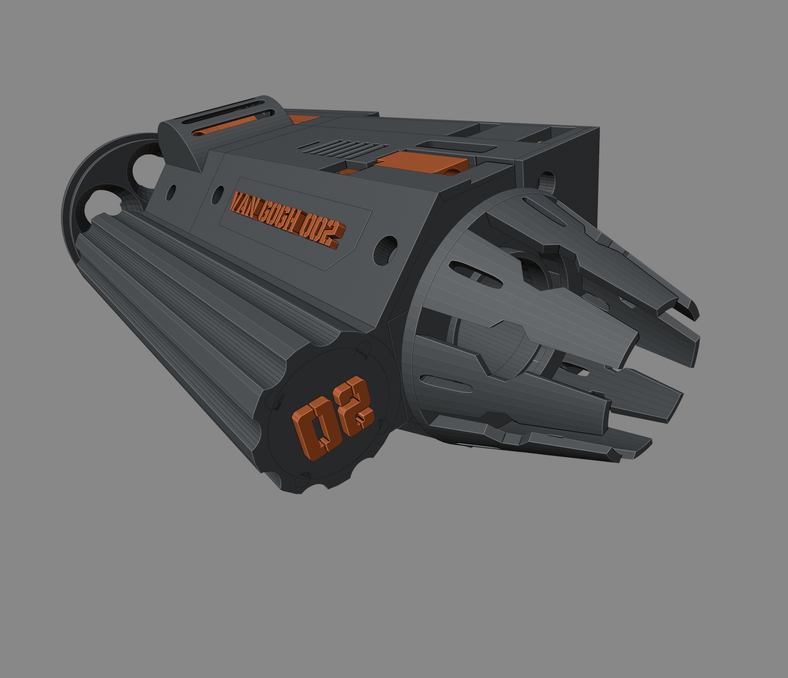
media/images/assembled-front.jpg
