Rhiiino/van-gogh/media/images/hero-assembled.jpg

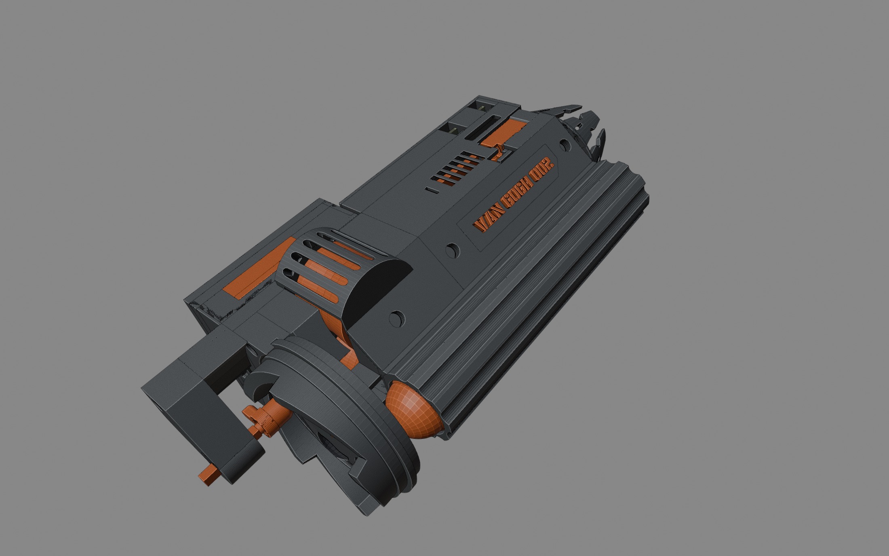
media/images/hero-assembled.jpg
