Rhiiino/van-gogh/kicad/barrel-logicBoard-vanGogh.kicad_pcb

## KiCad design kicad/barrel-logicBoard-vanGogh.kicad_pcb (2026-10-11)

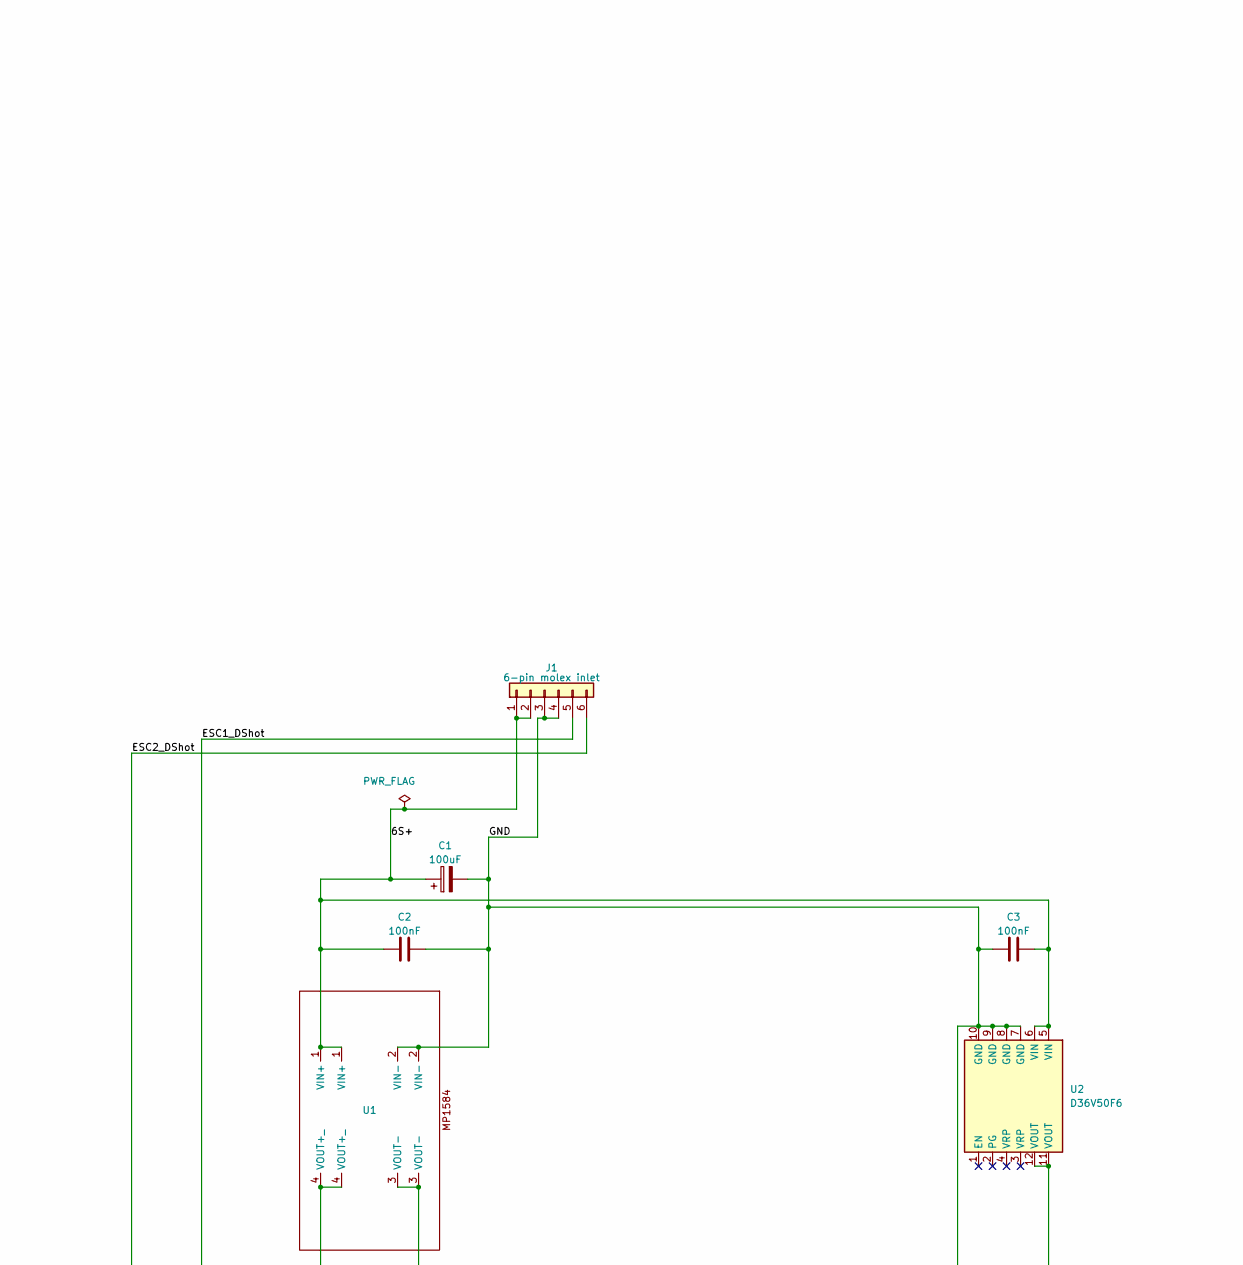
[picture p72: schematic barrel-logicBoard-vanGogh.kicad_sch, part in row 1, column 2]

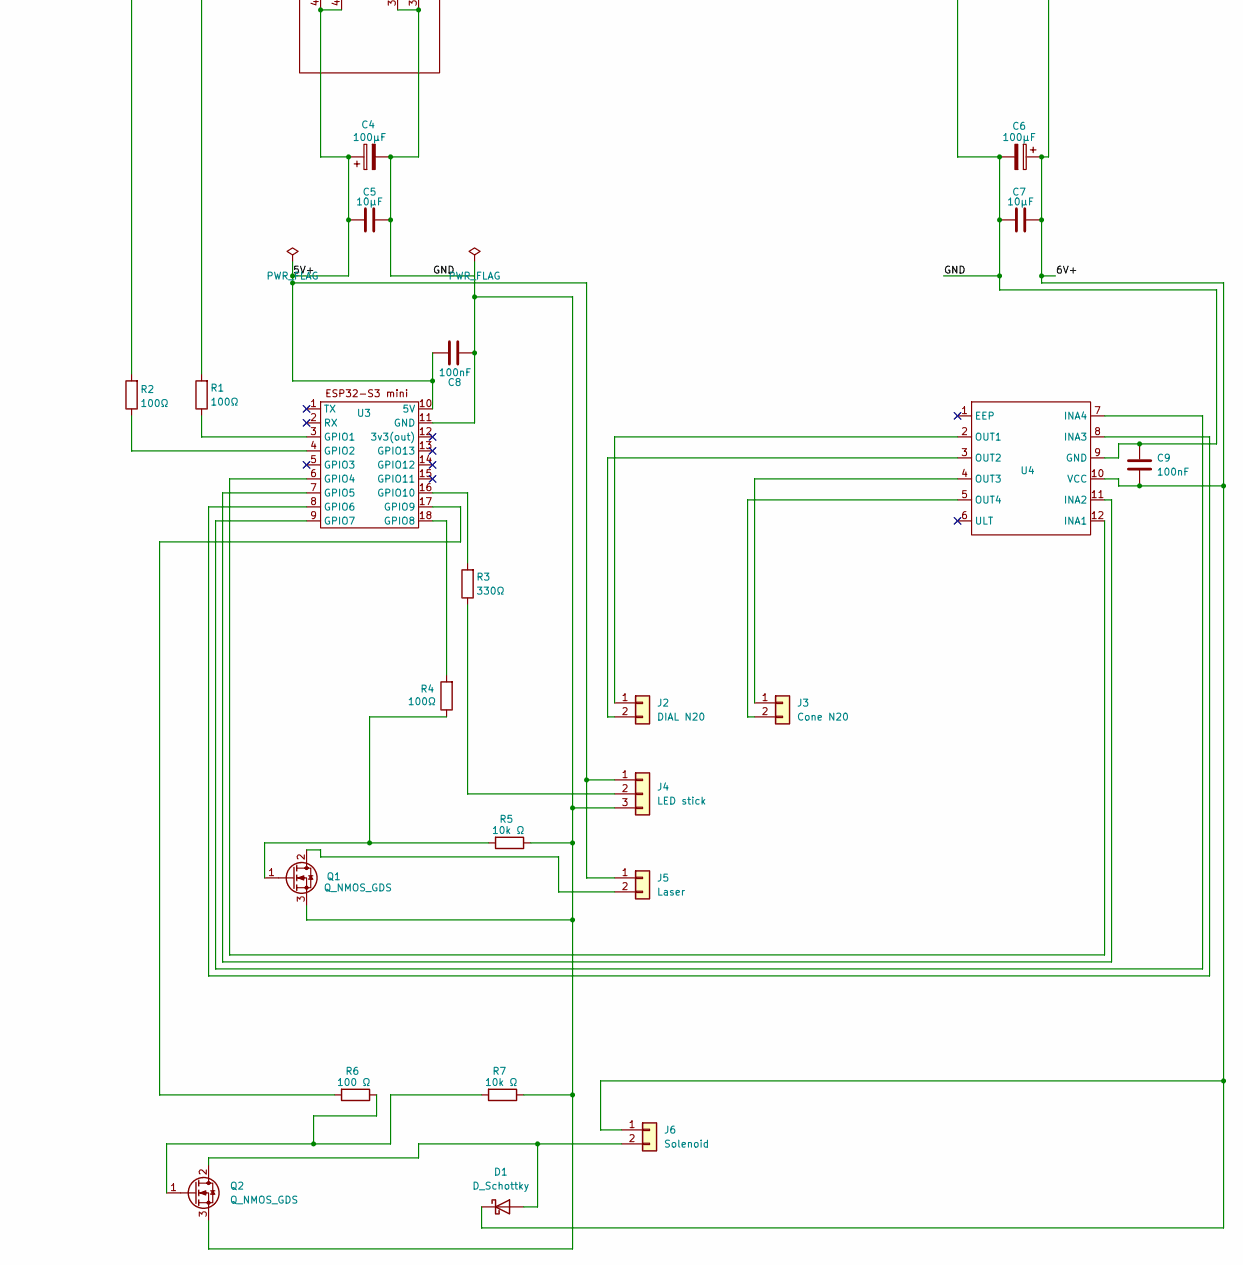
[picture p73: schematic barrel-logicBoard-vanGogh.kicad_sch, part in row 2, column 2]

Parts:
C1: 100uF; CP_Radial_D8.0mm_P3.50mm
C2, C3, C8, C9: 100nF; C_1206_3216Metric_Pad1.33x1.80mm_HandSolder
C4, C6: 100µF; CP_Radial_D6.3mm_P2.50mm
C5, C7: 10µF; C_1206_3216Metric_Pad1.33x1.80mm_HandSolder
D1: D_Schottky; D_SMA_Handsoldering
J1: 6-pin molex inlet; SolderWire-0.5sqmm_1x06_P4.6mm_D0.9mm_OD2.1mm
J2: DIAL N20; JST_PH_S2B-PH-K_1x02_P2.00mm_Horizontal
J3: Cone N20; JST_PH_S2B-PH-K_1x02_P2.00mm_Horizontal
J4: LED stick; JST_PH_S3B-PH-K_1x03_P2.00mm_Horizontal
J5: Laser; JST_PH_S2B-PH-K_1x02_P2.00mm_Horizontal
J6: Solenoid; JST_PH_S2B-PH-K_1x02_P2.00mm_Horizontal
Q1, Q2: Q_NMOS_GDS; TO-252-2
R1, R2, R4: 100Ω; R_1206_3216Metric_Pad1.30x1.75mm_HandSolder
R3: 330Ω; R_1206_3216Metric_Pad1.30x1.75mm_HandSolder
R5, R7: 10k Ω; R_1206_3216Metric_Pad1.30x1.75mm_HandSolder
R6: 100 Ω; R_1206_3216Metric_Pad1.30x1.75mm_HandSolder
U1: MP1584
U2: D36V50F6
U3: ESP32_s3_supermini
U4: DRV8833

Connections:
/5V+: C4.1, C5.1, C8.1, J4.1, J5.1, U1.4 (VOUT+_), U3.10 (5V)
/6S+: C1.1, C2.1, C3.2, J1.1, J1.2, U1.1 (VIN+), U2.5 (VIN), U2.6 (VIN)
/6V+: C6.1, C7.2, C9.2, D1.1 (K), J6.1, U2.11 (VOUT), U2.12 (VOUT), U4.10 (VCC)
/ESC1_DShot: J1.5, R1.2
/ESC2_DShot: J1.6, R2.2
/GND: C1.2, C2.2, C3.1, C4.2, C5.2, C6.2, C7.1, C8.2, C9.1, J1.3, J1.4, J4.3, Q1.3 (S), Q2.3 (S), R5.1, R7.1, U1.2 (VIN-), U1.3 (VOUT-), U2.7 (GND), U2.8 (GND), U2.9 (GND), U2.10 (GND), U3.11 (GND), U4.9 (GND)
unnamed: D1.2 (A), J6.2, Q2.2 (D)
unnamed: J2.1, U4.2 (OUT1)
unnamed: J2.2, U4.3 (OUT2)
unnamed: J3.1, U4.4 (OUT3)
unnamed: J3.2, U4.5 (OUT4)
unnamed: J4.2, R3.1
unnamed: J5.2, Q1.2 (D)
unnamed: Q1.1 (G), R4.1, R5.2
unnamed: Q2.1 (G), R6.1, R7.2
unnamed: R1.1, U3.3 (GPIO1)
unnamed: R2.1, U3.4 (GPIO2)
unnamed: U3.6 (GPIO4), U4.12 (INA1)
unnamed: U3.7 (GPIO5), U4.11 (INA2)
unnamed: U3.8 (GPIO6), U4.8 (INA3)
unnamed: U3.9 (GPIO7), U4.7 (INA4)
unnamed: R4.2, U3.18 (GPIO8)
unnamed: R6.2, U3.17 (GPIO9)
unnamed: R3.2, U3.16 (GPIO10)

Notes on the sheet:
Hey Chris.

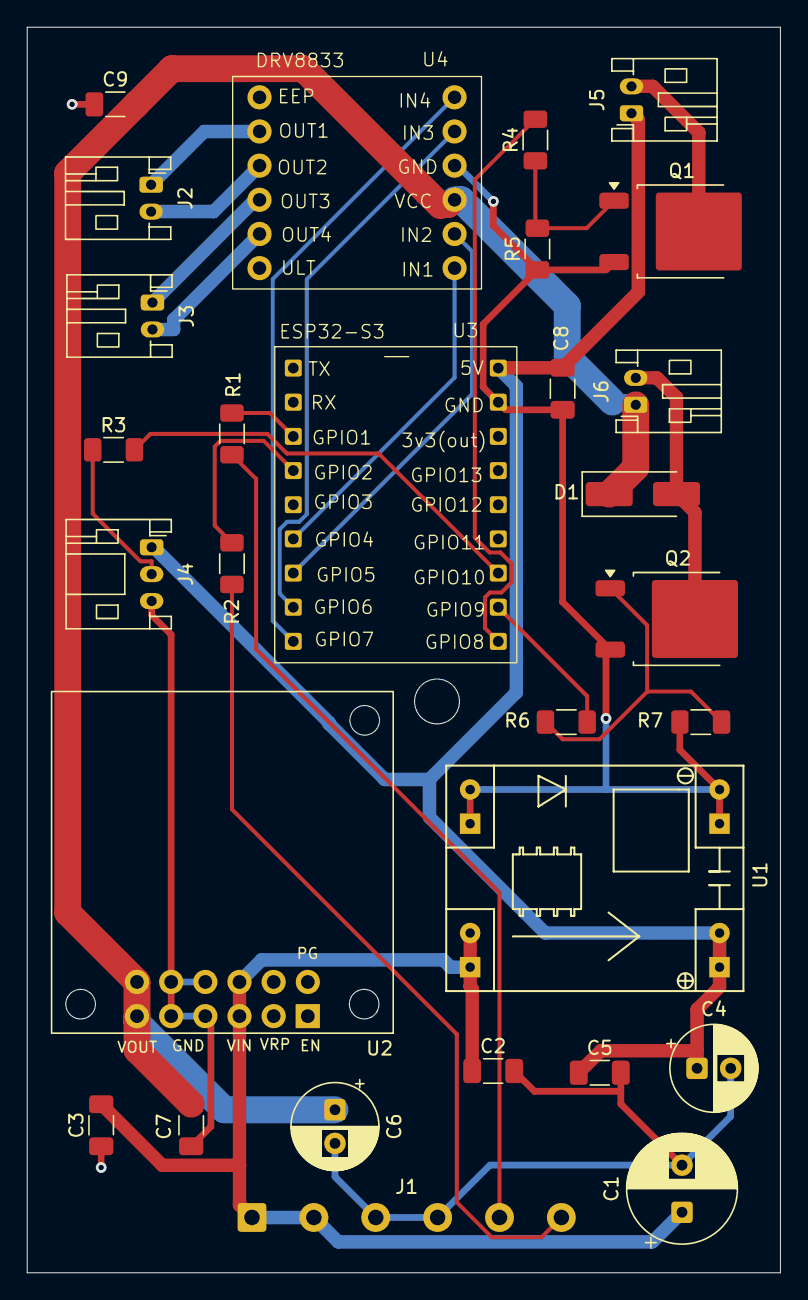
[picture p74: board barrel-logicBoard-vanGogh.kicad_pcb from above]

Board: 2 copper layers, 56.0 x 92.6 mm, 29 parts (0 on the bottom side), 24 nets.
