Rhiiino/van-gogh/(commit log)

2026-10-11 Publish the Van Gogh right barrel as its own project.
    [barrel-logicBoard-vanGogh.kicad_pcb, barrel-logicBoard-vanGogh.kicad_sch]
2026-10-11 Ignore GIF export scratch frames in the media folder.
2026-10-11 Link the hosted interactive model from the landing page.
2026-10-12 Show a Rival round beside the centered explode loop on the landing page.
2026-10-12 Publish the printed meshes and component-test firmware.
    [BCU cover.stl, ESC casing.stl, PH ceiling ∕ PYE connector.stl, actuation rod.stl, ammo guide.stl, barrel base L panel.stl, barrel base R panel.stl, barrel middle.stl]
2026-10-12 Price the connector kits by the pieces one barrel uses.
